Ekumen-OS/andino/(threads)

Thread 30 (2023-04-09):

[Simulation] Gazebo ROS control crashes the robot

stevendes, 2023-04-09:
### Summary

Using Gazebo ROS Control with the current robot configuration sometimes crashes the robot under specific movements, high values for the PID, or high-velocity commands being sent.

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

Different mass values improve the behavior, indicating that it could be an issue with the Inertia values and how Gazebo ROS control interacts.

### Definition of done
 - [ ] Gazebo ROS control works as expected.

francocipollone, 2024-03-20:
Closing as noetic isn't supported anymore

Closed 2024-03-20.

Thread 31 (2023-04-09):

[URDF] Wheel Axis are not aligned with base_link

stevendes, 2023-04-09:
### Summary

The current implementation of the Carpincho URDF has an offset between `base_link` and the `front_right_wheel` and `front_left_wheel`  axis, this influences localization since the robot movement also gets affected by that offset.

The fix would be to modify the position of `base_link` to be between the wheels, sharing the same axis.

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
_View of the base_link and the wheels_

### Definition of done
 - [ ] Carpincho URDF file updated with the correct values.

francocipollone, 2024-03-20:
Closing as it was part of the noetic branch which is not supported anymore

Closed 2024-03-20.

Thread 47 (2023-06-07):

Provide a gazebo simulation

francocipollone, 2023-06-07:
## Context
We already have a gazebo simulation at noetic branch but it was an old implementation. The urdf description way different than the current one.

## Summary
 - Create gazebo ROS2 simulation
 - Gracefully deal with urdf descriptions for:
   - real robot (ros2_control)
   - simulation using ros2_control
   - simulation using diff_drive plugin. (long shot, might not be necessary)

## Notes
 - an `andino_gazebo` package is expected to be created
 - I expect no gazebo references to andino_description's urdf description. Gazebo references should be part of the andino_gazebo package.

Voldivh, 2023-06-28:
## Task Description
Taking into account the initial issue description and that we have started working in doing a contribution for this issue, we have defined the following task in order to accomplish the

- [ ] The robot model for the Andino bot is included in the simulation environment within Gazebo Classic.
- [ ] The robot should be integrated with the following sensors:
- Wheel encoders
- Camera
- Lidar
- IMU (**if determined necessary, taking into account that the physical version of the Andino does not have an IMU**)
- [ ] Use ROS 2 Control to move the robot's wheels.
- [ ] Generate a launch file that is able to start the Gazebo simulation with the Andino bot in a environment.

### Notes
This feature should be implemented as a standalone package.

francocipollone, 2023-06-29:
Hey there I have some pointers on this topic.

## Implementation Suggestion

### URDF
- `andino_description` contains the description of the robot. I'd recommend not adding gazebo references within `andino_description` in order to make it simulator agnostic.
For so, I'd recommend having a xacro file within `andino_gazebo` package that include the main xacro from `andino_description` and add the gazebo references that this needs.

### ROS 2 control
Use https://github.com/ros-controls/gazebo_ros2_control . This package provides the "gazebo hardware interface" to be used between the diff drive controller and gazebo

### Sensors
IMU isn't part of the robot or the description yet. It's ok to add the IMU to the description, however, I'd suggest doing it in two steps. First, make sure the simulation is working with what you have as it is, and then, as a second step/enhacenment we can add the IMU to the description and the correspondent IMU controller(for gazebo).

agalbachicar, 2023-07-06:
@olmerg this ticket has been closed but I want to confirm:

- Have we decided to include the camera?
- Is ROS 2 Control finally working with the closed PR?

Closed 2023-07-05.

Thread 48 (2023-06-07):

Set up Nav2

francocipollone, 2023-06-07:
### Summary

Enable [nav2 navigation](https://github.com/ros-planning/navigation2) in Andino.

### Suggestions
 - [x] Provide an andino_navigation package.
 - [ ] Provide a basic launch file to bring up nav2: Check [nav2_bringup](https://github.com/ros-planning/navigation2/blob/main/nav2_bringup/launch/bringup_launch.py) launch file.
      - A configuration file is expected to be added to a config folder within the package for setting up different nav2's systems and to be loaded by the launch file.
      - Probably some topics in Andino/Nav2 should be remapped (or relayed)

### Extras

https://arxiv.org/abs/2307.15236

agalbachicar, 2023-06-28:
@nahueespinosa there is an effort that is about to start now that will take care of this. Have you started it already? If so, let's join forces!

nahueespinosa, 2023-06-28:
@francocipollone  In fact, I haven't started yet, but it should be very easy. I'll unassign myself then. Happy to help whoever is going to take care of this task.

Voldivh, 2023-06-29:
I believe the issue description provide the necessary tasks needed to complete the feature. I would just like to complete it with a couple of comments related to the scope of the effort that is starting:
- The implementation of the nav2 is related to be on top of the Andino simulation in Gazebo, taking into account the completion of #47.
- We are expecting to use the whole nav2 library in order to do localization, planning, navigation, etc. However, we would also like to assess the possibility of using Beluga in order to replace nav2_amcl. I think this should be assessed in terms of the amount of time that implementation would take. @nahueespinosa Could you provide us some insight about this topic?

agalbachicar, 2023-06-29:
To the best of my knowledge, @francocipollone did something already with it.

nahueespinosa, 2023-06-29:
> However, we would also like to assess the possibility of using Beluga in order to replace nav2_amcl.
> ...
> Could you provide us some insight about this topic?

We already did this, here is a branch with example launch files https://github.com/Ekumen-OS/beluga/pull/213.

To start setting up localization with `nav2_amcl`, I'd recommend using this file as reference: https://github.com/ros-planning/navigation2/blob/main/nav2_bringup/launch/localization_launch.py

`beluga_amcl` is a drop-in replacement, so once `nav2_amcl` is working, it is only a matter of installing Beluga from source and replacing the localization node name in a launch file.

@francocipollone got `slam_toolbox` working as well.

francocipollone, 2023-06-29:
I would start by setting up Nav2 as it is, once that is working we can parallel the work in order to choose `beluga` as the replacement for `nav2_amcl`. `Beluga`'s binaries are not yet released via ROS 2 build farm so it demands an extra step of building the library. For the simulation, we can simply add this step to the dockerfile. For the real robot it is necessary to bring the repo and build it.

> @francocipollone got slam_toolbox working as well.

I will push some stuff to launch `slam_toolbox` https://github.com/Ekumen-OS/andino/issues/49 shortly

PS: Thanks @nahueespinosa for the `beluga`'s info :rocket:

agalbachicar, 2023-07-06:
I know @olmerg did some progress on this yesterday.
CC @elector102 as you may also help here.

olmerg, 2023-07-06:
this is the initial branch [olmerg/nav2_gazebo](https://github.com/Ekumen-OS/andino/tree/olmerg/nav2_gazebo).

Which is expected in this package?

hidmic, 2024-02-06:
Is this complete @francocipollone ?

francocipollone, 2024-02-06:
Superseded by #190

Closed 2024-02-06.

Thread 55 (2023-06-18):

Add a mesh for the camera mount

francocipollone, 2023-06-18:
This PR #54 doesn't provide meshes for the visual of the camera.

Closed 2023-06-30.

Thread 80 (2023-06-30):

Fix urdf's distance between first and second story

francocipollone, 2023-06-30:
## Summary

Go over real robot sizes and adjust urdf description.

Closed 2023-06-30.

Thread 87 (2023-07-03):

Improve firmware code base

jballoffet, 2023-07-03:
## Desired behavior
Firmware code base shall be improved so as to ease its maintenance, decouple logic and drivers code (to ease the process of using a different dev board / microcontroller) and add unit tests.

elector102, 2023-07-06:
I can work on that! I have some experience and I made some investigation before for noah.

jballoffet, 2023-07-06:
Hi Fabri! I'm currently working on it, I will sync with you later on the lessons learned from the noahbot. Thanks for the heads up!

JesusSilvaUtrera, 2024-09-17:
@jballoffet we should close this issue since the PRs for improving the firmware were already merged.

jballoffet, 2024-09-17:
I concur, this can be closed now. Thanks!

Closed 2024-09-17.

Thread 92 (2023-07-04):

Adds tests for verifying andino_description urdf parsing.

francocipollone, 2023-07-04:
## Desired behavior
Adds some smoke tests in `andino_description` package for processing the xacro files and checking that there is no error when doing so.

JesusSilvaUtrera, 2024-05-10:
I will take this one. I suppose adding an unit test that loads the xacro file would be enough as a starting point.

Closed 2024-05-15.

Thread 93 (2023-07-06):

Wheel size does not match description/controller

BarceloChristian, 2023-07-06:
## Environment
* OS Version: <!-- e.g, Ubuntu 20.04 -->
* Source or binary build?
  <!-- If binary, which version? -->
  <!-- If source, which branch and what is the latest commit? -->

## Description
* Expected behavior:
  - Wheel size is defined the same across all the stack
* Actual behavior:
  - Wheel **Diameter** is defined to 0.035 for Gazebo's diff drive plugin ([here](https://github.com/Ekumen-OS/andino/blob/humble/andino_gazebo/urdf/andino.gazebo.xacro#L75))
  - Wheel **Radius** is defined to 0.0331 ([here](https://github.com/Ekumen-OS/andino/blob/humble/andino_description/config/andino/wheel.yaml#L2))

elector102, 2023-07-06:
@BarceloChristian @francocipollone what is the real value?

francocipollone, 2023-07-06:
> @BarceloChristian @francocipollone what is the real value?

The real value of the **Diameter** is 6.6 cm

agalbachicar, 2024-03-19:
@JesusSilvaUtrera will take care right away of this task as he gets to know the platform and this seems to be great issue to begin with.

JesusSilvaUtrera, 2024-03-20:
I have created this [https://github.com/Ekumen-OS/andino/pull/230](PR) for this issue

Closed 2024-03-20.

Thread 94 (2023-07-06):

Wrong xacro:if/unless definition for wheel's mesh

BarceloChristian, 2023-07-06:
## Description
* Expected behavior:
  - A single mesh is added to wheels, with different directives depending if scale is defined or not
* Actual behavior:
  - Meshes are added twice if scale is not defined

## Steps to reproduce
<!-- Provide steps so we can try to reproduce this issue -->

1. Transpile Andino's xacro, and check the wheels' mesh field.

Closed 2023-07-06.

Thread 96 (2023-07-06):

Caster wheel have a wrong behavior

elector102, 2023-07-06:
## Environment
* OS Version: 22.04
* Source

## Description
* Expected behavior: robot moving regarding command vels
* Actual behavior: caster wheel is stuck and don't move correctly

## Steps to reproduce

1. Run Andino simulation on empty world,
2. move the robot and rotate.

## Output
robot movement on gazebo is not regarding with the command vels. I will fix that commands

elector102, 2023-07-06:
I will fix that.

Closed 2023-07-06.

Thread 99 (2023-07-06):

Add option to generate Fixed or Continuous joint for caster wheel

BarceloChristian, 2023-07-06:
## Desired behavior
The caster wheel rotates freely when the robot moves

## Implementation suggestion
Add a flag to XACRO to generate the required joints.
Keep default as is

Closed 2023-07-06.

Thread 110 (2023-07-12):

simulation problem of andino with ros control

olmerg, 2023-07-12:
## Environment
* OS Version: Ubuntu 22.04 (dockerfile)
* Source from humble branch

## Description
* Expected behavior: After delete the hack in andino_gazebo/launch/spawn_robot_launch.py (function get_robot_description) the robot simulation with ros control works  without any issue
* Actual behavior:Gazebo simulation with ros control and caster wheel working complete  made that the robot do not move in straight-line.

## Steps to reproduce

1. Delete line in andino_gazebo/launch/spawn_robot_launch.py
   ```
    robot_desc = robot_desc.replace(
        '<joint name="caster_rotation_joint" type="continuous">',
        '<joint name="caster_rotation_joint" type="fixed">',
    )
   ```
2. Follow readme of andino_gazebo to build the packages
3. run simulation with ros control
`ros2 launch andino_gazebo andino_one_robot.launch.py use_gazebo_ros_control:=true`
5. move the robot from ros using
`ros2 run teleop_twist_keyboard teleop_twist_keyboard cmd_vel:=diff_controller/cmd_vel_unstamped`

## Output

After solve this problem is required to add to the joint_state_publisher plugin the joint to solve robot_state_publishers problems.

We have tested changing with different values the friction in   andino_gazebo/urdf/andino.gazebo.xacro without success. Some comments you can found in the pull #105

Closed 2023-10-09.

Thread 117 (2023-07-13):

The dependencies are not well fulfilled.

elector102, 2023-07-13:
## Environment
* OS Version: ubuntu 22, ros humble
* Source, humble branch

## Description
We are having some dependencies issues using humble branch on a CI. You can see the current dependencies on that image:
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

The problem is that andino Gazebo and andino description depend on andino control, and this dependency is fulfilled indirectly.
on the CI we run to compile and then run the test the following:
`colcon build --packages-up-to andino_gazebo aws_robomaker_small_warehouse_world andino_master --event-handlers console_cohesion+
`
and then:
`colcon test --packages-select andino_gazebo aws_robomaker_small_warehouse_world andino_master --event-handlers console_cohesion+`
where andino_master are gazebo tests.
With that the dependency of andino gazebo is not fulfilled and CI fail

francocipollone, 2023-07-13:
Thanks for filling up the issue @elector102 : Check https://github.com/Ekumen-OS/andino/pull/118

francocipollone, 2023-07-13:
> CI fail

What is the issue?

Now I am realizing that it is ok that `andino_control` is not a dependency to `andino_gazebo`. I think that the dependency that is missing is `controller_manager`

francocipollone, 2023-07-13:
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

Oh yeat it is being used when finding the controller's parameters

https://github.com/Ekumen-OS/andino/blob/5236b1132343539e19c2eb63c61e5f5f7814555b/andino_gazebo/urdf/andino.gazebo.xacro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

agalbachicar, 2023-07-13:
There is another occurency:

https://github.com/Ekumen-OS/andino/blob/humble/andino_description/urdf/andino.urdf.xacro#L84-L87

That imports files from `andino_control` and if `andino_description` includes `andino_control` as a dependency, then you have a circle one.

#118 deals with the issue, but the urdf files need to be ordered to solve this problem.

francocipollone, 2023-07-13:
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

```xml
<xacro:include filename="$(find ${package_name})/urdf/include/andino_control.urdf.xacro" />
```

Here `package_name` unpacks to `andino_description` so it isn't looking for stuff in `andino_control` package.
So I don't see the cycling dependency.

**It is true though** that if we are strict we could move the `andino_control.xacro.urdf` to `andino_control` package in order to extend the base description to ros control if needed.

However, based on taking a look at other robots descriptions, in general they add the ros control stuff within the base urdf description and it is quite accepted.

francocipollone, 2023-08-02:
Pinging @agalbachicar to define the bug if any. I will close this otherwise

Closed 2023-10-11.

Thread 121 (2023-07-14):

License notice missing on Docker bash scripts

jballoffet, 2023-07-14:
## Desired behavior
The license notice is currently missing on some Docker bash scripts.

Closed 2023-07-14.

Thread 134 (2023-08-05):

L298N wiring diagram not correct

Russ76, 2023-08-05:
Do you really have your robot driving around with wiring like in the diagram under hardware?

For it appears somewhat like the wiring for a stepper motor, but L298N can only control one stepper motor!

For powering two motors, with variable speeds, the wiring connections are different.

https://tronixstuff.com/2014/11/25/tutorial-l298n-dual-motor-controller-modules-and-arduino/

Also, the 5V terminal is for output, not for input. The Voltage regulator on the module can supply 5V to Arduino or encoders if properly wired.

Russ

## Environment
* OS Version: <!-- e.g, Ubuntu 20.04 -->
* Source or binary build?
  <!-- If binary, which version? -->
  <!-- If source, which branch and what is the latest commit? -->

## Description
* Expected behavior: <!-- Tell us what you expected to happen -->
* Actual behavior: <!-- What happened instead -->

## Steps to reproduce
<!-- Provide steps so we can try to reproduce this issue -->

1.
2.
3.

## Output
<!-- Provide screenshots, console logs, backtraces, and/or anything that could
be useful to us resolving this issue -->

francocipollone, 2023-08-06:
Thanks for commenting, let me go through your comment.

> For it appears somewhat like the wiring for a stepper motor, but L298N can only control one stepper motor!

L298N can control one stepper motor or two dc motors. The latter is our case, so we are ok.

> For powering two motors, with variable speeds, the wiring connections are different.

Base on what you say that the connection is different? Can you elaborate?

> Also, the 5V terminal is for output, not for input.

That's depend, you can remove the jumper (as indicated in the picture) and avoid using the internal 5v regulator to supply directly the current for the l298.

> The Voltage regulator on the module can supply 5V to Arduino or encoders if properly wired.

That's a decision yes, you can go that path. The diagram is a suggestion that works but the end design is open to the user.
For example, adding a step up to raise to 9V from 5V the voltage of the motor (at the l298 input) is a recommendation to have better reaction from the motors.

Russ76, 2023-08-06:
For powering two motors, the enable pins are necessary and are used for PWM for motors. The other two pair are for direction control and are only digital high or low. It looks to me like you have wiring connections correct for the BTS controller, which uses 2 PWM wires for each motor, one for forward, and one for reverse.

Closed 2023-12-07.

Thread 135 (2023-08-16):

Allow to load custom configuration for the description

francocipollone, 2023-08-16:
### Context

Nowadays the configuration files that describe the robot are located at:
https://github.com/Ekumen-OS/andino/tree/humble/andino_description/config/andino

However if the user wanted to have it a bit different; `motors` added in a different manner, `lidar` displaced and connected somwhere else, `base` with different size; they should create their own URDF files as the configuration files are harcoded within the [`xacro` file](https://github.com/Ekumen-OS/andino/blob/humble/andino_description/urdf/andino.urdf.xacro)

### Proposal
- Modify the xacro to receive by argument the path to the configuration files
- Use as default the current files if no argument is passed down to the xacro files.
- Modify the launch file to accept passing the path to the configuration yaml.

### Also!
 - Update documentation

JesusSilvaUtrera, 2024-03-26:
@francocipollone We should close this issue if it is already solved and merged

jballoffet, 2024-05-08:
@lneumarkt, are you currently working on this? No worries if not, just let us know since @JesusSilvaUtrera was considering picking it up. Thanks!

lneumarkt, 2024-05-08:
I'm not working on is. Feel free to pick it up

jballoffet, 2024-05-08:
Got it, thanks @lneumarkt for the prompt response!

JesusSilvaUtrera, 2024-05-09:
Thanks @lneumarkt for the response, I will take this issue.

Closed 2024-05-15.

Thread 148 (2023-09-04):

Velocity not limited for the diff drive controller

IDavGal, 2023-09-04:
## Description
The [`andino_controllers.yaml`](https://github.com/Ekumen-OS/andino/blob/humble/andino_control/config/andino_controllers.yaml) configuration file specify no limits in the linear/angular velocity. According the [motor's description](https://www.sparkfun.com/products/16413) its max velocity is 90 RPM, given the wheel radius this would translate to roughly 0.33 m/s linear vel.
The `diff_drive_controller` handles both [velocities limits separately](https://github.com/ros-controls/ros2_controllers/blob/1dac309979fb9392dc12feb6b46555582fed6fc6/diff_drive_controller/src/diff_drive_controller.cpp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), so the border case in which `linear_vel + angular_vel` translates to a higher motor velocity than 90 RPM is not considered by this calculation.

IDavGal, 2023-10-04:
There is an open PR in [`ros2_controllers`](https://github.com/ros-controls/ros2_controllers/pull/471) addressing this issue, although is currently pause.
I'll try to either bump it up or address the issues myself.

francocipollone, 2023-10-04:
> There is an open PR in [`ros2_controllers`](https://github.com/ros-controls/ros2_controllers/pull/471) addressing this issue, although is currently pause. I'll try to either bump it up or address the issues myself.

I should run a local test in the real robot and provide a real-based approximation, wdyt?
My estimation is that we are going to be below 0.5 m/s without effort.

Thread 159 (2023-09-28):

andino_base fails build in ros build farm

francocipollone, 2023-09-28:
### Summary

andino_base package is failing to build in the ros build farm due to

```
10:35:36 [ 42%] Building CXX object applications/CMakeFiles/motor_driver_demo.dir/motor_driver_demo.cpp.o
10:35:36 [ 57%] Linking CXX executable motor_driver_demo
10:35:36 /usr/bin/ld: CMakeFiles/motor_driver_demo.dir/motor_driver_demo.cpp.o: in function `andino_base::MotorDriver::MotorDriver()':
10:35:36 motor_driver_demo.cpp:(.text._ZN11andino_base11MotorDriverC2Ev[_ZN11andino_base11MotorDriverC5Ev]+0x18): undefined reference to `LibSerial::SerialPort::SerialPort()'
10:35:36 /usr/bin/ld: CMakeFiles/motor_driver_demo.dir/motor_driver_demo.cpp.o: in function `andino_base::MotorDriver::~MotorDriver()':
10:35:36 motor_driver_demo.cpp:(.text._ZN11andino_base11MotorDriverD2Ev[_ZN11andino_base11MotorDriverD5Ev]+0x18): undefined reference to `LibSerial::SerialPort::~SerialPort()'
10:35:36 /usr/bin/ld: ../src/libmotor_driver.so: undefined reference to `LibSerial::SerialPort::SetCharacterSize(LibSerial::CharacterSize const&)'
10:35:36 /usr/bin/ld: ../src/libmotor_driver.so: undefined reference to `LibSerial::SerialPort::Write(std::__cxx11::basic_string<char, std::char_traits<char>, std::allocator<char> > const&)'
10:35:36 /usr/bin/ld: ../src/libmotor_driver.so: undefined reference to `LibSerial::SerialPort::FlushIOBuffers()'
10:35:36 /usr/bin/ld: ../src/libmotor_driver.so: undefined reference to `LibSerial::SerialPort::SetBaudRate(LibSerial::BaudRate const&)'
10:35:36 /usr/bin/ld: ../src/libmotor_driver.so: undefined reference to `LibSerial::SerialPort::ReadLine(std::__cxx11::basic_string<char, std::char_traits<char>, std::allocator<char> >&, char, unsigned long)'
10:35:36 /usr/bin/ld: ../src/libmotor_driver.so: undefined reference to `LibSerial::SerialPort::Open(std::__cxx11::basic_string<char, std::char_traits<char>, std::allocator<char> > const&, std::_Ios_Openmode const&)'
10:35:36 /usr/bin/ld: ../src/libmotor_driver.so: undefined reference to `LibSerial::SerialPort::IsOpen() const'
10:35:36 /usr/bin/ld: ../src/libmotor_driver.so: undefined reference to `LibSerial::SerialPort::SetRTS(bool)'
10:35:36 /usr/bin/ld: ../src/libmotor_driver.so: undefined reference to `LibSerial::SerialPort::SetStopBits(LibSerial::StopBits const&)'
10:35:36 /usr/bin/ld: ../src/libmotor_driver.so: undefined reference to `LibSerial::SerialPort::SetFlowControl(LibSerial::FlowControl const&)'
10:35:36 /usr/bin/ld: ../src/libmotor_driver.so: undefined reference to `LibSerial::SerialPort::SetDTR(bool)'
10:35:36 /usr/bin/ld: ../src/libmotor_driver.so: undefined reference to `LibSerial::SerialPort::SetParity(LibSerial::Parity const&)'
10:35:36 collect2: error: ld returned 1 exit status
10:35:36 gmake[2]: *** [applications/CMakeFiles/motor_driver_demo.dir/build.make:98: applications/motor_driver_demo] Error 1
10:35:36 gmake[1]: *** [CMakeFiles/Makefile2:172: applications/CMakeFiles/motor_driver_demo.dir/all] Error 2
10:35:36 gmake: *** [Makefile:146: all] Error 2
```

See https://build.ros2.org/job/Hdev__andino__ubuntu_jammy_amd64/3/console

francocipollone, 2023-10-03:
From jenkins output:
```
Could NOT find PkgConfig (missing: PKG_CONFIG_EXECUTABLE)
```

https://build.ros2.org/job/Hdev__andino__ubuntu_jammy_amd64/3/console

Closed 2023-10-04.

Thread 160 (2023-10-02):

Improve lidar mesh

francocipollone, 2023-10-02:
## Description
* Current lidar mesh is unnecessarily too complex (more than 26k triangles), which might cause an issue when using this mesh in simulations and for correctly casting shadows

Closed 2023-10-09.

Thread 169 (2023-10-30):

Adds camera_info yaml file

francocipollone, 2023-10-30:
### Summary

When launching the camera we are not passing a yaml with the description of the camera's intrinsics

https://github.com/Ekumen-OS/andino/blob/024b6943e5813c2b555b3f74e0e4e97f8ed21cba/andino_bringup/launch/camera.launch.py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

### Notes

- https://navigation.ros.org/tutorials/docs/camera_calibration.html#overview
- https://gitlab.com/boldhearts/ros2_v4l2_camera
- https://github.com/tier4/ros2_v4l2_camera/blob/87d0ff0d24302124ee9a4b8e00ad6d675446b2e3/launch/v4l2_camera.launch.py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

### Definition of done

 - [ ] Adds a default yaml file descringin camera intrinsic.
 - [ ] Adds documentation about how to calibrate the camera if needed.

JesusSilvaUtrera, 2024-03-20:
I will take care of this issue

JesusSilvaUtrera, 2024-03-20:
I have created this [PR](https://github.com/Ekumen-OS/andino/pull/231) @agalbachicar

Closed 2024-06-17.

Thread 170 (2023-10-30):

Enable compressed image transport

francocipollone, 2023-10-30:
### Summary

Nowadays the images from the camera are only raw images

### Notes

 - Simply installing the correspondent image transport plugijn will enable the compressed image to be also published
 - In order to visualize images in RViz2 you will need to uncompress the image as it natively doesn't support compressed images to be viewed.
   - `ros2 run image_transport republish compressed in/compressed:=image_raw/compressed raw out:=image_raw/uncompressed`
### Definition of done

- [ ] Provide compressed image transport
- [ ] Adds documentation about compressed image visualization

JesusSilvaUtrera, 2024-03-20:
I will take care of this issue

JesusSilvaUtrera, 2024-03-20:
I have reviewed this, and the package 'ros-humble-image-transport-plugins' is installed automatically when the 'rosdep' command is used, as well as its dependencies (```sudo apt install libtheora-dev libogg-dev libboost-python-dev```), so there are no changes needed there.

On the other side, as 'ros-humble-image-transport' is also installed when running 'rosdep', we can use the 'republish' node to uncompress the image and see it in RViz:

```sh
ros2 run image_transport republish raw --ros-args --remap in:=/image_raw/compressed --remap out:=/image_raw/uncompressed
```

The syntax used for this node is different than the one @francocipollone used, because it says that syntax is deprecated.

For evidence, you can see the output of the node 'list_transports':

```sh
jesus-silva@themis:~/ws$ ros2 run image_transport list_transports
Declared transports:
image_transport/compressed
image_transport/compressedDepth
image_transport/raw
image_transport/theora

Details:
----------
"image_transport/compressed"
 - Provided by package: compressed_image_transport
 - Publisher:
      This plugin publishes a CompressedImage using either JPEG or PNG compression.

 - Subscriber:
      This plugin decompresses a CompressedImage topic.

----------
"image_transport/compressedDepth"
 - Provided by package: compressed_depth_image_transport
 - Publisher:
      This plugin publishes a compressed depth images using PNG compression.

 - Subscriber:
      This plugin decodes a compressed depth images.

----------
"image_transport/raw"
 - Provided by package: image_transport
 - Publisher:
      This is the default publisher. It publishes the Image as-is on the base topic.

 - Subscriber:
      This is the default pass-through subscriber for topics of type sensor_msgs/Image.

----------
"image_transport/theora"
 - Provided by package: theora_image_transport
 - Publisher:
      This plugin publishes a video packet stream encoded using Theora.

 - Subscriber:
      This plugin decodes a video packet stream encoded using Theora.
```

I will try to test this with my webcam as I don't have the Andino at home to check all works without problems.

JesusSilvaUtrera, 2024-03-20:
I have been struggling for a while to open my webcam using image_transport:

```sh
[ WARN:0] global ./modules/videoio/src/cap_gstreamer.cpp (616) isPipelinePlaying OpenCV | GStreamer warning: GStreamer: pipeline have not been created
[ WARN:0] global ./modules/videoio/src/cap_v4l.cpp (890) open VIDEOIO(V4L2:/dev/video0): can't open camera by index
[ros2run]: Process exited with failure 1
```

When I perform a ```ls /dev/video*´´´ the webcam is found, but I think docker is not able to access it inside the container, since the container is not being run with 'privileged' access. I have tried with an app like 'cheese' and indeed, the webcam is not being accessed even though it is detected, so I can't continue with this.

JesusSilvaUtrera, 2024-03-20:
@agalbachicar to keep you updated.

francocipollone, 2024-03-20:
> When I perform a ```ls /dev/video*´´´ the webcam is found, but I think docker is not able to access it inside the container, since the container is not being run with 'privileged' access. I have tried with an app like 'cheese' and indeed, the webcam is not being accessed even though it is detected, so I can't continue with this.

Are you using the docker provided in this repo? It is actually running with `--privileged` flag

https://github.com/Ekumen-OS/andino/blob/humble/docker/run.sh#L107-L116

Probably you could try also adding a bind volume `-v` to /dev. You can modify the run.sh script locally for trying that

JesusSilvaUtrera, 2024-03-20:
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

Yeah I am using the docker provided, so if it uses the ```--privileged``` flag by default it is a strange behavior. I will try what you suggests later, thanks Franco!

JesusSilvaUtrera, 2024-03-21:
@francocipollone trying with the new volume worked, now I can see my webcam inside the docker container and I can publish the images as ROS msg.

The results are that indeed if the plugins are installed (and they are installed by default after `rosdep`) these topics are published:

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

So as you can see both the compressed and the raw image are published, so there is no need to 'republish' the compressed image as raw to see it in RViz, you can simply use the raw image in RViz.

The problem with this is the bandwidth, because it would be more convenient if we could simply publish only the formats we want (in this case the raw and compressed, the others are not important).

I will look into that and be back here

JesusSilvaUtrera, 2024-03-21:
I have tried it, and although the topic is being republished with `sensor_msgs/msg/Image` type, it is not possible to see it on RViz:

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

On the other hand, I have looked if it is possible to publish only some of transports, and the only information I have found is [this](https://github.com/ros-perception/image_transport_tutorials?tab=readme-ov-file#adding-new-transports) so far.

JesusSilvaUtrera, 2024-03-22:
@agalbachicar in case you want to check the updates :)

JesusSilvaUtrera, 2024-05-24:
@francocipollone I think we can close this issue given the results:

- The compressed image is being published automatically when you have the plugins installed, and the node also publishes the original image uncompressed.
- Rviz2 still doesn't support compressed images visualization, but we can use the original uncompressed `/camera/image` topic.

Let me know what you think and if you want to test anything else now that I have the Raspy Cam.

francocipollone, 2024-06-09:
Sorry for the late reply.
Thanks for the investigation @JesusSilvaUtrera, it is much appreciated!
We can close this

Closed 2024-06-09.

Thread 174 (2023-11-19):

Terminate called after throwing an instance of 'std::runtime_error'

mlde50, 2023-11-19:
## Environment
* OS Version:
```
lsb_release -a
No LSB modules are available.
Distributor ID:	Ubuntu
Description:	Ubuntu 22.04.3 LTS
Release:	22.04
Codename:	jammy
```
* ROS2 Humble updated
* Andino - Commits on Oct 9, 2023

## Description
* Check motor with motor_driver_demo
```
 motor_driver_demo --msg='o 255 255'
```
* Actual behavior:
```$ motor_driver_demo --msg='o 255 255'
Motor driver is connected: True
Waiting 2 seconds for the Microcontroller to be ready...
Sending message: o 255 255
Response to o 255 255 timed out.
Response:
terminate called after throwing an instance of 'std::runtime_error'
  what():  Input/output error
Aborted (core dumped)
```
## Steps to reproduce
1.
```
$ motor_driver_demo --serial_port=/dev/ttyUSB0 --msg='e'
```
2.
```
$ motor_driver_demo --msg='o 255 255'
```

## Output
1.
```
Motor driver is connected: True
Waiting 2 seconds for the Microcontroller to be ready...
Sending message: e
Response: 0 0
```
2.
```
Motor driver is connected: True
Waiting 2 seconds for the Microcontroller to be ready...
Sending message: o 255 255
Response to o 255 255 timed out.
Response:
terminate called after throwing an instance of 'std::runtime_error'
  what():  Input/output error
Aborted (core dumped)
```

francocipollone, 2023-11-21:
Hey @mlde50 thanks for filling this in, I will try to replicate this locally whenever I have a chance.
In the meantime, just in case, have you checked the configuration part at https://github.com/Ekumen-OS/andino/tree/humble/andino_hardware#arduino ?

francocipollone, 2023-11-21:
@mlde50  Note that the `motor_driver_demo` app is just sending messages to the Arduino. You can try sending those very same commands via Arduino IDE so we can narrow down the issue and check if your connection with the Arduino is working properly.

After loading the firmware into the Arduino uno/nano platform you can open the Serial Monitor, indicate the Baud Rate(57600) and  CR (carriage return)

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

 and send:
- `e` --> for getting the encoders values
- `o 255 255`

This is a bit explained at https://github.com/Ekumen-OS/andino/tree/humble/andino_firmware#andino_firmware

mlde50, 2023-11-22:
Hey @francocipollone, thanks for your reply. I did more investigation with latest commit and Arduino monitor application tool. And I have some strange behavior. When power on arduino Nano, "e" command return encoder value
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

But when I send "o 255 255" command motor doesn't rotate and communication between computer and Arduino is lost, impossible to resend now command without unplug and plugin arduino.

mlde50, 2023-11-25:
Hey @francocipollone, I reinstall every things and it's seems ok  now.

Closed 2023-11-25.

Thread 184 (2023-11-29):

Arduino Firmware - Command "o" not working

german-e-mas, 2023-11-29:
## Description
After compiling and uploading the [andino_firmware](https://github.com/Ekumen-OS/andino/tree/humble/andino_firmware) into the Arduino, the `o` command did not work.

Commands such as `m 255 255` were correctly interpreted. The speed was also properly controlled (`128` was half as fast, for example). But the `o` command did nothing. It did not move the motors.

## Environment
- https://github.com/Ekumen-OS/andino/tree/humble/andino_firmware

jballoffet, 2023-11-29:
Thanks @german-e-mas for reporting this issue!

I confirm that I am able to reproduce the issue locally. I will dive into this as part of the work that I'm currently doing related to refactoring the code related to the commands and the application main loop (https://github.com/Ekumen-OS/andino/blob/humble/andino_firmware/src/app.cpp).

Thank you!

Closed 2024-02-12.

Thread 188 (2023-12-04):

CI failing due to upstream error

francocipollone, 2023-12-04:
### Context

CI is failing due to a certain collision between empy and em packages.

```
  [1.140s] ERROR:colcon.colcon_core.entry_point:Exception loading extension 'colcon_core.shell.powershell': cannot import name 'OVERRIDE_OPT' from 'em' (/usr/local/bin/em.py) The Python package 'empy' must be installed and 'em' must not be installed since both packages share the same namespace
  Traceback (most recent call last):
    File "/usr/local/lib/python3.10/dist-packages/colcon_core/entry_point.py", line 120, in load_entry_points
      extension_type = load_entry_point(entry_point)
    File "/usr/local/lib/python3.10/dist-packages/colcon_core/entry_point.py", line 166, in load_entry_point
      return entry_point.load()
    File "/usr/local/lib/python3.10/dist-packages/pkg_resources/__init__.py", line 2465, in load
      return self.resolve()
    File "/usr/local/lib/python3.10/dist-packages/pkg_resources/__init__.py", line 2471, in resolve
      module = __import__(self.module_name, fromlist=['__name__'], level=0)
    File "/usr/local/lib/python3.10/dist-packages/colcon_powershell/shell/powershell.py", line 17, in <module>
      from colcon_core.shell.template import expand_template
    File "/usr/local/lib/python3.10/dist-packages/colcon_core/shell/template/__init__.py", line 19, in <module>
      raise e from None
    File "/usr/local/lib/python3.10/dist-packages/colcon_core/shell/template/__init__.py", line 10, in <module>
      from em import OVERRIDE_OPT
  ImportError: cannot import name 'OVERRIDE_OPT' from 'em' (/usr/local/bin/em.py) The Python package 'empy' must be installed and 'em' must not be installed since both packages share the same namespace

```

It doesn't seem it is coming from our end

### Next steps
 - Investigate why this is failing

Closed 2023-12-04.

Thread 190 (2023-12-15):

Improve andino_navigation package

francocipollone, 2023-12-15:
### Summary

Improve `andino_navigation` package to make it easier to the user to use nav2 on the real robot as well as to decouple `andino_navigation` from the simulation.

### Tasks:
 - [x] Test `andino_navigation/launch/bringup.launch.py` launch file with real robot.
       - Tune parameters for a better experience.
       - Note odom topic is different in simulation and in real robot. (Should we here try to standarize it?)
         - Temporarily having two param files might be ok.
 - [ ] ~Include nav bringup at a `andino_bringup` package level so it is easier to launch everything.~
 - [ ] Move `andino_navigation/launch/andino_simulation_navigation.launch.py` file to `andino_gz_classic` package as it depends on gazebo.

agalbachicar, 2024-02-06:
If I may:

>  Include nav bringup at a andino_bringup package level so it is easier to launch everything.

Keep it separate and be more atomic with your package dependencies. If you just want to have basic sensor / actuator functionality, the nav stack would make it bring a plethora of dependencies you don't want.

> Move andino_navigation/launch/andino_simulation_navigation.launch.py file to andino_gz_classic package as it depends on gazebo.

Actually, one of the things I struggled the most with is the coupling in the packages. I would highly recommend to have launchfiles that are specific to the nav stack than only care about loading the nodes that are required for that and then demos / integration packages that would put pieces together. That would help also to make sure you can select, as a user, where to launch things (physical machine / docker container).

francocipollone, 2024-02-13:
> Keep it separate and be more atomic with your package dependencies. If you just want to have basic sensor / actuator functionality, the nav stack would make it bring a plethora of dependencies you don't want.

Thanks for the suggestion. Agree with you about the dependencies nav2 would bring at `andino_bringup` package

Closed 2024-02-14.

Thread 192 (2023-12-21):

Migrate to modern Gazebo

azeey, 2023-12-21:
## Desired behavior
As you may know, Gazebo-classic (aka Gazebo11, see [Terminology](https://gazebosim.org/about#:~:text=Terminology)) is no longer being actively developed  and will not be available on ROS Jazzy ([REP 2000](https://www.ros.org/reps/rep-2000.html#jazzy-jalisco-may-2024-may-2029)). I noticed that this project still uses Gazebo-classic. Are there any plans to migrate to modern Gazebo ([previously known as Ignition](https://community.gazebosim.org/t/a-new-era-for-gazebo/1356))?

## Alternatives considered
n/a

## Implementation suggestion
Steps for Migration:

- Follow https://gazebosim.org/api/sim/8/migrationsdf.html to update SDF files
- Follow https://gazebosim.org/api/sim/8/migrationplugins.html to update custom plugins
- Update launch files to use [ros_gz](https://github.com/gazebosim/ros_gz/) instead of gazebo_ros_pkgs. Documentation for ros_gz can be found at https://gazebosim.org/docs/harmonic/ros2_integration. Another good resource is the [ros_gz_project_template](https://gazebosim.org/docs/harmonic/ros_gz_project_template_guide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).

## Additional context
n/a

francocipollone, 2023-12-21:
Hey @azeey thanks for the issue and suggestion in the implementation :smile: , it is useful indeed.
Happy to mention that it is already part of our backlog and it is under migration. We haven't opened it yet but we will do so shortly. (It isn't completely migrated I think we are still missing the sensors)

This won't replace the current gz_classic simulation but will provide an alternative, similar to what we did with [andino_webots](https://github.com/Ekumen-OS/andino_webots)

azeey, 2023-12-21:
That's great to hear!vLet me know if you run into any issues.

francocipollone, 2023-12-21:
> That's great to hear!vLet me know if you run into any issues.

Thanks!, I'll keep you posted! :rocket:

francocipollone, 2024-02-02:
- :heavy_check_mark:  Tackled at https://github.com/Ekumen-OS/andino_gz
- :heavy_check_mark:  Referenced at the readme: https://github.com/Ekumen-OS/andino?tab=readme-ov-file#paperclips-related-projects

Closed 2024-02-02.

Thread 198 (2023-12-28):

Camera from RPI has a driver issue in Ubuntu Mate 22.04 which prevents proper loading

agalbachicar, 2023-12-28:
## Environment
* OS Version: RPI 4, Ubuntu Mate 22.04.3, humble
* Source or binary build: source build, [2e552b5](https://github.com/Ekumen-OS/andino/commit/2e552b51e3333d6e2c6186defe8b8a15ad370f9d)

## Description
* Expected behavior: after running the installation guide in the RPI, and launching the base launchfile the camera would be up and working.
* Actual behavior: it does not work, fails with:
```
[v4l2_camera node-3] [ERROR] [1703759493.768683193] [v4l2_camera]: Failed stream start: Invalid argument (22)
```

## Steps to reproduce

1. Run the installation instructions in https://github.com/Ekumen-OS/andino/blob/humble/andino_hardware/README.md
2. Go to https://github.com/Ekumen-OS/andino/blob/humble/README.md#rocket-usage and try:
```
ros2 launch andino_bringup andino_robot.launch.py
```
The launch execution would fail with that error listed above.

## Notes

I checked and it seems this is a known error:

- https://robotics.stackexchange.com/questions/23967/raspberry-pi-ros-2-humble-on-ubuntu-22-04-server-v4l2-camera-reports-failed
- https://gitlab.com/boldhearts/ros2_v4l2_camera/-/issues/45

It seems there is a workaround with raspian distros, however I did not find the `/boot/firmware/config.txt` or any similar file under the `/boot` directory nor that configuration in any other file (`camera_auto_detect`).

## Hardware

- Rasberry PI camera module 2
- Raspberry PI 4 B 8GB

flsmr, 2024-05-19:
For me, the following fix got my raspi cam v2 work again (Ubuntu Mate 22.04 on Raspberry Pi 4B):
change/add the following lines within /boot/firmware/config.txt:

```
# Autoload overlays for any recognized cameras or displays that are attached
# to the CSI/DSI ports. Please note this is for libcamera support, *not* for
# the legacy camera stack
start_x=1
gpu_mem=128
# camera_auto_detect=1
```

francocipollone, 2024-05-19:
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

Thanks for sharing the fix @flsmr

JesusSilvaUtrera, 2024-05-27:
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

Exactly, I have tried my raspi cam v2 today and this was the solution to make it work, apart from enabling it in the raspberry configuration:

```
sudo raspi-config
```

Go to `Interface Options`, select `camera` and enable it. Then you just need to reboot and the camera should be working fine.

francocipollone, 2024-05-27:
We should update this fix to the instructions in case others face this very same issue.

JesusSilvaUtrera, 2024-05-27:
> We should update this fix to the instructions in case others face this very same issue.

I'm on it, it will be included in the #231 PR

Thread 200 (2023-12-28):

Provide a dockerized environment for ARM64

agalbachicar, 2023-12-28:
## Desired behavior

Reduce the time to deploy an Andino bot in a fully functional system.

## Alternatives considered

Probably there are many out there, like from a bash script, having an image of the SD card, etc. etc. etc.
However, I think that starting by having a dockerized version that can be built in a host machine (x86) that mimics the build procedure in the final architecture (arm64) allows to catch issues with incompatible processes and test many things in CI (not yet, Github Actions doesn't support arm64 yet).

## Implementation suggestion

I would consider building in stages and providing multiple images:

- Image for development in RPI, but with no workspace specific dependency. (A)
- Image that clones the repo, installs the workspace, builds and tests the packages in andino. (B)
- Image that mounts the repo as a volume and it is suitable for continuous development. (C)

B depends on A.
C depends on A.

A and B can be distributed via Github, probably.

## Additional context

Running https://github.com/Ekumen-OS/andino/tree/humble/andino_hardware is tedious. At least, we can reduce the burden by providing the specifics of software packages installed in a docker container.

agalbachicar, 2023-12-28:
Connected with https://github.com/Ekumen-OS/andino/discussions/20

agalbachicar, 2024-01-02:
Connected to #51

marcoshuck, 2024-01-03:
https://docs.docker.com/build/ci/github-actions/multi-platform/ In case this becomes relevant. You can set up QEMU to build arm64.

Thread 201 (2023-12-29):

Fix rosdep dependencies when installing in Raspeberry Pi

agalbachicar, 2023-12-29:
## Environment
* OS Version: Ubuntu 22.04 / Ubuntu Mate 22.04 - arm64/v8
* Source build: [9f7793d](https://github.com/Ekumen-OS/andino/commit/9f7793db6810d6d4deeca745ef18aeb86660a444)

## Description
* Expected behavior: running rosdep as listed in the guide does not lead to any error.
* Actual behavior: because the repository has the simulation packages, it fails to resolve all gazebo related dependencies and also one related to the turtlebot3 (potentially unused).

## Steps to reproduce

1. Run rosdep as described above and in the readmes when running in the RPI.

```
rosdep install --from-paths src --ignore-src -i -y
```

## Output

```
rosdep install --from-paths src --ignore-src -i -y
[...]
ERROR: the following rosdeps failed to install                                    
   apt: command [sudo -H apt-get install -y ros-humble-turtlebot3-gazebo] failed   
   apt: command [sudo -H apt-get install -y ros-humble-gazebo-ros-pkgs] failed     
   apt: command [sudo -H apt-get install -y ros-humble-gazebo-ros] failed          
   apt: command [sudo -H apt-get install -y ros-humble-gazebo-ros2-control] failed 
   apt: Failed to detect successful installation of [ros-humble-turtlebot3-gazebo] 
   apt: Failed to detect successful installation of [ros-humble-gazebo-ros-pkgs]   
   apt: Failed to detect successful installation of [ros-humble-gazebo-ros]        
   apt: Failed to detect successful installation of [ros-humble-gazebo-ros2-control]
```

agalbachicar, 2023-12-29:
I suspect we need to move the simulation specific packages to another repository to solve this issue.

robofoundry, 2024-01-27:
I ran into same issue and as instructions suggest you can continue installing remaining packages by using rosdep with -r switch OR you can also add COLCON_IGNORE empty file in package root folder you want to ignore. In this case it would be gz_classic, nav and slam packages. Or you can simply delete those three package directories on robot/RPi. HTH.

JesusSilvaUtrera, 2024-09-17:
@jballoffet I suppose we can also close this one, as using the `-r` flag with `rosdep` command solves the problem and also on Jazzy we have deprecated the simulation packages.

Thread 236 (2024-04-25):

Add support for the Bitcraze™ Lighthouse Positioning System

hidmic, 2024-04-25:
## Desired behavior
<!-- Describe the current problem and the feature you want implemented.-->
The [Lighthouse Positioning System](https://www.bitcraze.io/documentation/system/positioning/ligthouse-positioning-system/) by Bitcraze is a low-cost pose estimation system for their flagship product, the Crazyflie MAV. It uses a number of IR beacons and a receiver on a deck (the equivalent of Arduino shields) to provide the Crazyflie MAV with pose estimates in real-time.

If we could leverage this deck, we could provide Andino with pose tracking support. This is immensely useful when validating, tuning, and benchmarking localization, mapping, and navigation systems. Also when teaching about them.

## Alternatives considered
<!-- Describe alternate solutions or features you've considered.-->
There are other, full blown motion capture solutions in the market but these are exceedingly expensive when compared with Andino's target budget. We are talking tens of thousands of US dollars.

## Implementation suggestion
<!-- Provide a suggestion on how to implement this feature, which could help us
expedite this implementation.-->

The one difficulty with this is that both the hardware interface and the communication protocol are very loosely documented. The pinout for the [Lighthouse Positioning deck](https://www.bitcraze.io/documentation/hardware/lighthouse_deck/lighthouse_deck-datasheet.pdf) and for [Crazyflie expansion decks](https://www.bitcraze.io/documentation/system/platform/cf2-expansiondecks/) in general is public. The firmware that talks to this deck is also open source (see [here](https://github.com/bitcraze/crazyflie-firmware/tree/d9ee34a78cecf2eaf8b05e0b54487cff0c7b4590/src/modules/src/lighthouse) and [here](https://github.com/bitcraze/crazyflie-firmware/tree/d9ee34a78cecf2eaf8b05e0b54487cff0c7b4590/src/utils/src/lighthouse)). But the protocol itself is nowhere to be found. It can only be reversed engineered. It shouldn't be difficult to do so for one of the typical on-board computers for Andino (e.g. an RPi4).

hidmic, 2024-04-25:
> But the protocol itself is nowhere to be found. It can only be reversed engineered.

Aha! This may not be 100% true. We shall take a look at some of the documentation and tools over at https://github.com/bitcraze/lighthouse-fpga. Thanks @glpuga.

JCarosella, 2024-04-27:
Some info here, found the [Bitcrazy API for deck drivers](https://www.bitcraze.io/documentation/repository/crazyflie-firmware/master/userguides/deck/). This will help understand the src code linked above for the lighthouse driver code

JCarosella, 2024-05-02:
## Status update:

I was able to hook up the board to a RPi4 and start receiving data from the sensors with which the positioning algorithm could be implemented.

The bad news: I mistakenly connected the VCC/GND pins backwards and most likely burnt something. Most likely because the board turns on and responds to commands, but does not output sensor info (I think [the TS4231 IR receivers](https://www.bitcraze.io/documentation/hardware/lighthouse_deck/lighthouse_deck-revd.pdf) burnt).

I will be getting a replacement, but that puts the project on hold for a while (no US market, only Europe). I'll keep this issue updated.

Thread 239 (2024-04-30):

Update connections diagram

JesusSilvaUtrera, 2024-04-30:
## Desired behavior
The connections diagram doesn't include all the required parts and it is out-of-date, so it would be nice to update it with the latest changes to ease the assembly process.

## Implementation suggestion
Several considerations:
- The encoders and the motors are the same piece, so they should be together.
- The Raspberry is not included in the diagram
- Add the power part well explained, replacing the potato.
- The Arduino UNO should be replaced by an Arduino Nano (optional but the most used is the Nano for this robot)
- Add the LiDAR (optional as its wiring is not something too hard)

## Additional context

JesusSilvaUtrera, 2024-05-08:
To keep the issue updated, I am creating 3 diagrams in Google Drawings, one with the Arduino connections, the second with Raspberry Pi connections and the third for Power connections. I think this way is easier to follow the diagrams and then just connects the different diagrams into the final robot.

They won't be finished until I test them assembling my own robot.

francocipollone, 2024-05-08:
> To keep the issue updated, I am creating 3 diagrams in Google Drawings, one with the Arduino connections, the second with Raspberry Pi connections and the third for Power connections. I think this way is easier to follow the diagrams and then just connects the different diagrams into the final robot.
>
> They won't be finished until I test them assembling my own robot.

Sounds good!

Closed 2024-05-28.

Thread 240 (2024-04-30):

Update bill of materials

JesusSilvaUtrera, 2024-04-30:
## Desired behavior
There are some considerations to be taken into account with the bill of materials:
- The variants column should be removed IMO, because this robot is meant for people learning, and this would only create confusion in which parts to use.
- If the variants column is finally removed, the comments column should be removed too.
- The parts should be numerated in the table. This way we can edit the photos of the assembly process to show how every part look, at least in the first photo where all parts are shown (think about a person that is totally new to this and have never seen a Motor Driver in his life).
- Right now the links used are from the US if I am right, it would be nice to add links for EMEA also.

## Implementation suggestion
Update the README.md in `andino_hardware` with all these changes.

## Additional context
We can discuss other changes that you think it would be nice to add, or discard some of the ones I have proposed.

Closed 2024-04-30.

Thread 247 (2024-05-13):

USB ports not being well fixed on Raspberry Pi

JesusSilvaUtrera, 2024-05-13:
## Environment
* OS Version: Ubuntu 22.04 Mate
* Source or binary build?
  Using source code with branch `humble` and last commit `efb75b0`.

## Description
* Expected behavior: I am setting up everything in the Raspberry Pi 4B to use the LiDAR and the Arduino.  Following the instruction on the section `USB Port name configuration` in the `README.md` of `andino_hardware` package should lead to the result of the ports being well fixed..

* Actual behavior: When I follow the instructions to set the ports, I can see both the LiDAR and Arduino connected to USB ports. However, when I set the rules, only the first 2 lines of the expected output are visible, so the rules are not being well applied.

```sh
crw-rw---- 1 root dialout 188, 0 Sep  2 15:09 /dev/ttyUSB0
crw-rw---- 1 root dialout 188, 1 Sep  2 15:09 /dev/ttyUSB1
lrwxrwxrwx 1 root root         7 Sep  2 15:09 /dev/ttyUSB_ARDUINO -> ttyUSB0
lrwxrwxrwx 1 root root         7 Sep  2 15:09 /dev/ttyUSB_LIDAR -> ttyUSB1
```

## Steps to reproduce

1. Install `Ubuntu 22.04 Mate` on the Raspberry Pi
2. Execute `sudo apt update && sudo apt upgrade` to upgrade the OS packages
3. Follow the `README.md` of `andino_hardware`, section `USB Port name configuration`

## Output
<!-- Provide screenshots, console logs, backtraces, and/or anything that could
be useful to us resolving this issue -->

JesusSilvaUtrera, 2024-05-13:
My bad, the problem was a typo when I copied one of the ids and I didn't notice earlier. I also discovered that there is a preset rule for the RPLiDAR, if you execute `ls -l /dev | grep ttyUSB`, you will see that there is a `rplidar -> ttyUSB1` also.

Sorry for the inconveniences, I will now close the issue.

Closed 2024-05-13.

Thread 250 (2024-05-24):

[Hardware] - Update Raspberry Cam parts

JesusSilvaUtrera, 2024-05-24:
## Desired behavior
I have recently printed the 3D parts for the Raspberry Camera and noticed that the hinge model doesn't include the holes to screw it to the chassis (it would be nice if they can be M2 or M3). Also, the front and the back parts doesn't fit exactly, so I will need to add some silicon to them.

## Implementation suggestion
Modify the models in `andino_hardware/printing_model/raspi_cam_mount` to satisfy these new requirements.

## Additional context
The holes should coincide with the 2 holes at the front of the chassis.

Closed 2025-01-28.

Thread 272 (2024-10-27):

FAIL TO 'colcon build' THE FIRST TIME

thanhtruongphan, 2024-10-27:
Hello everyone! 👋

I just tried to download andino_repositories, and follow the README.md instructions to install.

But I have some problems when I use _**colcon build**_

1. When I ```colcon build``` the first time:
>>>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

I solved by ```sudo apt install ros-humble-ros2-control```

2. When I ```colcon build``` the second time:
>>> 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

I solved by ```sudo apt install ros-humble-ament-cmake-clang-format```

3. When I ```colcon build``` the third time:
>>>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

I solved by ```sudo apt install libserial-dev```

4. When I ```colcon build``` the fourth time:
>>>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

I solved by ```sudo apt-get install libgflags-dev```

5. When I ```colcon build``` the fifth time:
>>>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

... and now I don't know how to solve it.

Help me, pls.

Thank you all so much, and have a nice day! 🥹

thanhtruongphan, 2024-10-27:
UPDATE:

I tried to mode the line 12 and It's OK now.
>>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

result:
>>>>>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

thanhtruongphan, 2024-10-27:
and in SBC:
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

francocipollone, 2024-10-27:
Hey @thanhtruongphan , thanks for the issue creation.

1. I feel like the issues with the stuff not installed is due to some missing rosdep install: e.g: typically `rosdep install --from-paths src -y -i`

2. Regarding the issues and the modifications to the CMakeLists file you are doing. It is odd and not happening on my end last time a built everything (I am going to try asap when I return from a trip). Could you share your setup? e.g: OS / hardware/ etc

thanhtruongphan, 2024-10-28:
yeah!
you're right!

after ```sudo rosdep init``` and ```rosdep update```, I forget to ```rosdep install --from-paths src -y -i``` 😄

probably because of the errors in the previous project that made me stupid.

anyway, thank you so much for your reply.

have a nice day 🥹

Closed 2024-10-31.

Thread 274 (2024-10-28):

HOW TO RUN ON REAL ROBOT

thanhtruongphan, 2024-10-28:
I've set up all firmware both on SBC and dev-PC, 👋

I could run gazebo with teleop-twist-keyboard successfully,

but the Real-robot doesn't work...
I don't know how to do...

Can anyone help me, pls...

Thank you so much and have a nice day!! 🥹

>>> ![Screenshot 2024-10-28 214557](https://github.cI've set up all firmware both on SBC and dev-PC, 👋

I could run gazebo with teleop-twist-keyboard successfully,

but the Real-robot doesn't work...
I don't know how to do...

Can anyone help me, pls...

Thank you so much and have a nice day!! 🥹

>>> 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
om/user-attachments/assets/7fb6fad4-d259-4203-9086-bdbc40ba6baf)

thanhtruongphan, 2024-10-29:
I tried with the data 'o 255 255' to serial but nothing happen...
>>> 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

thanhtruongphan, 2024-11-02:
oh, oh, maybe Ubuntu on VMvirtualbox machine can connect properly with SBC,

now I can use teleop_twist_keyboard to control two motors.

but, maybe I have some problem,
**when I run command ```ros2 launch andino_bringup andino_robot.launch.py```**:

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

more detail:
```
[INFO] [launch]: All log files can be found below /home/truongpt/.ros/log/2024-11-02-11-05-19-391756-truongpt-sbc-96943
[INFO] [launch]: Default logging verbosity is set to INFO
[INFO] [robot_state_publisher-1]: process started with pid [97024]
[robot_state_publisher-1] [WARN] [1730520322.065477803] [kdl_parser]: The root link base_link has an inertia specified in the URDF, but KDL does not support a root link with an inertia.  As a workaround, you can add an extra dummy link to your URDF.
[robot_state_publisher-1] [INFO] [1730520322.071813321] [robot_state_publisher]: got segment base_footprint
[robot_state_publisher-1] [INFO] [1730520322.074996867] [robot_state_publisher]: got segment base_link
[robot_state_publisher-1] [INFO] [1730520322.075066514] [robot_state_publisher]: got segment camera_link
[robot_state_publisher-1] [INFO] [1730520322.075105976] [robot_state_publisher]: got segment caster_base_link
[robot_state_publisher-1] [INFO] [1730520322.075141049] [robot_state_publisher]: got segment caster_rotation_link
[robot_state_publisher-1] [INFO] [1730520322.075173660] [robot_state_publisher]: got segment caster_wheel_link
[robot_state_publisher-1] [INFO] [1730520322.075205585] [robot_state_publisher]: got segment left_motor
[robot_state_publisher-1] [INFO] [1730520322.075237066] [robot_state_publisher]: got segment left_wheel
[robot_state_publisher-1] [INFO] [1730520322.075268898] [robot_state_publisher]: got segment right_motor
[robot_state_publisher-1] [INFO] [1730520322.075300379] [robot_state_publisher]: got segment right_wheel
[robot_state_publisher-1] [INFO] [1730520322.075331786] [robot_state_publisher]: got segment rplidar_laser_link
[robot_state_publisher-1] [INFO] [1730520322.075363415] [robot_state_publisher]: got segment second_base_link
[INFO] [v4l2_camera_node-2]: process started with pid [97086]
[INFO] [rplidar_composition-3]: process started with pid [97105]
[v4l2_camera_node-2] [INFO] [1730520325.915706520] [v4l2_camera]: Driver: bm2835 mmal
[v4l2_camera_node-2] [INFO] [1730520325.916024772] [v4l2_camera]: Version: 331683
[v4l2_camera_node-2] [INFO] [1730520325.916058753] [v4l2_camera]: Device: mmal service 16.1
[v4l2_camera_node-2] [INFO] [1730520325.916080919] [v4l2_camera]: Location: platform:bcm2835-v4l2-0
[v4l2_camera_node-2] [INFO] [1730520325.916101271] [v4l2_camera]: Capabilities:
[v4l2_camera_node-2] [INFO] [1730520325.916121659] [v4l2_camera]:   Read/write: YES
[v4l2_camera_node-2] [INFO] [1730520325.916141955] [v4l2_camera]:   Streaming: YES
[v4l2_camera_node-2] [INFO] [1730520325.916184195] [v4l2_camera]: Current pixel format: YUYV @ 640x480
[v4l2_camera_node-2] [INFO] [1730520325.917353745] [v4l2_camera]: Available pixel formats:
[v4l2_camera_node-2] [INFO] [1730520325.917410170] [v4l2_camera]:   YU12 - Planar YUV 4:2:0
[v4l2_camera_node-2] [INFO] [1730520325.917433188] [v4l2_camera]:   YUYV - YUYV 4:2:2
[v4l2_camera_node-2] [INFO] [1730520325.917452965] [v4l2_camera]:   RGB3 - 24-bit RGB 8-8-8
[v4l2_camera_node-2] [INFO] [1730520325.917472632] [v4l2_camera]:   JPEG - JFIF JPEG
[v4l2_camera_node-2] [INFO] [1730520325.917491909] [v4l2_camera]:   H264 - H.264
[v4l2_camera_node-2] [INFO] [1730520325.917511131] [v4l2_camera]:   MJPG - Motion-JPEG
[v4l2_camera_node-2] [INFO] [1730520325.917530279] [v4l2_camera]:   YVYU - YVYU 4:2:2
[v4l2_camera_node-2] [INFO] [1730520325.917549315] [v4l2_camera]:   VYUY - VYUY 4:2:2
[v4l2_camera_node-2] [INFO] [1730520325.917568648] [v4l2_camera]:   UYVY - UYVY 4:2:2
[v4l2_camera_node-2] [INFO] [1730520325.917587481] [v4l2_camera]:   NV12 - Y/CbCr 4:2:0
[v4l2_camera_node-2] [INFO] [1730520325.917606629] [v4l2_camera]:   BGR3 - 24-bit BGR 8-8-8
[v4l2_camera_node-2] [INFO] [1730520325.917625591] [v4l2_camera]:   YV12 - Planar YVU 4:2:0
[v4l2_camera_node-2] [INFO] [1730520325.917644887] [v4l2_camera]:   NV21 - Y/CrCb 4:2:0
[v4l2_camera_node-2] [INFO] [1730520325.917664294] [v4l2_camera]:   RX24 - 32-bit XBGR 8-8-8-8
[v4l2_camera_node-2] [INFO] [1730520325.917684109] [v4l2_camera]: Available controls:
[v4l2_camera_node-2] [INFO] [1730520325.917723200] [v4l2_camera]:   Brightness (1) = 50
[v4l2_camera_node-2] [INFO] [1730520325.917758366] [v4l2_camera]:   Contrast (1) = 0
[v4l2_camera_node-2] [INFO] [1730520325.917790606] [v4l2_camera]:   Saturation (1) = 0
[v4l2_camera_node-2] [INFO] [1730520325.917822847] [v4l2_camera]:   Red Balance (1) = 1000
[v4l2_camera_node-2] [INFO] [1730520325.917853290] [v4l2_camera]:   Blue Balance (1) = 1000
[v4l2_camera_node-2] [INFO] [1730520325.917882790] [v4l2_camera]:   Horizontal Flip (2) = 0
[v4l2_camera_node-2] [INFO] [1730520325.917912104] [v4l2_camera]:   Vertical Flip (2) = 0
[v4l2_camera_node-2] [INFO] [1730520325.917942326] [v4l2_camera]:   Power Line Frequency (3) = 1
[v4l2_camera_node-2] [INFO] [1730520325.917972473] [v4l2_camera]:   Sharpness (1) = 0
[v4l2_camera_node-2] [INFO] [1730520325.918002287] [v4l2_camera]:   Color Effects (3) = 0
[v4l2_camera_node-2] [INFO] [1730520325.918031935] [v4l2_camera]:   Rotate (1) = 0
[v4l2_camera_node-2] [INFO] [1730520325.918061416] [v4l2_camera]:   Color Effects, CbCr (1) = 32896
[v4l2_camera_node-2] [ERROR] [1730520325.918107896] [v4l2_camera]: Failed getting value for control 10027009: Permission denied (13); returning 0!
[v4l2_camera_node-2] [INFO] [1730520325.918183043] [v4l2_camera]:   Codec Controls (6) = 0
[v4l2_camera_node-2] [INFO] [1730520325.918218950] [v4l2_camera]:   Video Bitrate Mode (3) = 0
[v4l2_camera_node-2] [INFO] [1730520325.918250671] [v4l2_camera]:   Video Bitrate (1) = 10000000
[v4l2_camera_node-2] [INFO] [1730520325.918281578] [v4l2_camera]:   Repeat Sequence Header (2) = 0
[v4l2_camera_node-2] [ERROR] [1730520325.918313059] [v4l2_camera]: Failed getting value for control 10029541: Permission denied (13); returning 0!
[v4l2_camera_node-2] [INFO] [1730520325.918335299] [v4l2_camera]:   Force Key Frame (4) = 0
[v4l2_camera_node-2] [INFO] [1730520325.918364613] [v4l2_camera]:   H264 Minimum QP Value (1) = 0
[v4l2_camera_node-2] [INFO] [1730520325.918394872] [v4l2_camera]:   H264 Maximum QP Value (1) = 0
[v4l2_camera_node-2] [INFO] [1730520325.918424445] [v4l2_camera]:   H264 I-Frame Period (1) = 60
[v4l2_camera_node-2] [INFO] [1730520325.918454889] [v4l2_camera]:   H264 Level (3) = 11
[v4l2_camera_node-2] [INFO] [1730520325.918484203] [v4l2_camera]:   H264 Profile (3) = 4
[v4l2_camera_node-2] [ERROR] [1730520325.918514740] [v4l2_camera]: Failed getting value for control 10092545: Permission denied (13); returning 0!
[v4l2_camera_node-2] [INFO] [1730520325.918535684] [v4l2_camera]:   Camera Controls (6) = 0
[v4l2_camera_node-2] [INFO] [1730520325.918564776] [v4l2_camera]:   Auto Exposure (3) = 0
[v4l2_camera_node-2] [INFO] [1730520325.918595294] [v4l2_camera]:   Exposure Time, Absolute (1) = 1000
[v4l2_camera_node-2] [INFO] [1730520325.918625812] [v4l2_camera]:   Exposure, Dynamic Framerate (2) = 0
[v4l2_camera_node-2] [INFO] [1730520325.918656811] [v4l2_camera]:   Auto Exposure, Bias (9) = 12
[v4l2_camera_node-2] [INFO] [1730520325.918686570] [v4l2_camera]:   White Balance, Auto & Preset (3) = 1
[v4l2_camera_node-2] [INFO] [1730520325.918715976] [v4l2_camera]:   Image Stabilization (2) = 0
[v4l2_camera_node-2] [INFO] [1730520325.922449233] [v4l2_camera]:   ISO Sensitivity (9) = 0
[v4l2_camera_node-2] [INFO] [1730520325.922537157] [v4l2_camera]:   ISO Sensitivity, Auto (3) = 1
[v4l2_camera_node-2] [INFO] [1730520325.922574545] [v4l2_camera]:   Exposure, Metering Mode (3) = 0
[v4l2_camera_node-2] [INFO] [1730520325.922610545] [v4l2_camera]:   Scene Mode (3) = 0
[v4l2_camera_node-2] [ERROR] [1730520325.922649173] [v4l2_camera]: Failed getting value for control 10289153: Permission denied (13); returning 0!
[v4l2_camera_node-2] [INFO] [1730520325.922675062] [v4l2_camera]:   JPEG Compression Controls (6) = 0
[v4l2_camera_node-2] [INFO] [1730520325.922707135] [v4l2_camera]:   Compression Quality (1) = 30
[v4l2_camera_node-2] [WARN] [1730520325.927204802] [v4l2_camera_node]: Control type not currently supported: 6, for control: Codec Controls
[v4l2_camera_node-2] [WARN] [1730520325.928066803] [v4l2_camera_node]: Control type not currently supported: 4, for control: Force Key Frame
[v4l2_camera_node-2] [WARN] [1730520325.928623588] [v4l2_camera_node]: Control type not currently supported: 6, for control: Camera Controls
[v4l2_camera_node-2] [WARN] [1730520325.929047116] [v4l2_camera_node]: Control type not currently supported: 9, for control: Auto Exposure, Bias
[v4l2_camera_node-2] [WARN] [1730520325.929344351] [v4l2_camera_node]: Control type not currently supported: 9, for control: ISO Sensitivity
[v4l2_camera_node-2] [WARN] [1730520325.929761638] [v4l2_camera_node]: Control type not currently supported: 6, for control: JPEG Compression Controls
[v4l2_camera_node-2] [INFO] [1730520325.930008948] [v4l2_camera_node]: camera calibration URL: file:///home/truongpt/ws/install/andino_bringup/share/andino_bringup/config/raspicam.yaml
[v4l2_camera_node-2] [WARN] [1730520325.940628174] [v4l2_camera_node]: [mmal_service_16.1] does not match narrow_stereo in file /home/truongpt/ws/install/andino_bringup/share/andino_bringup/config/raspicam.yaml
[v4l2_camera_node-2] [INFO] [1730520325.943830424] [v4l2_camera]: Starting camera
[v4l2_camera_node-2] [ERROR] [1730520325.944354672] [v4l2_camera]: Buffer failure on capture start: Device or resource busy (16)
[rplidar_composition-3] [INFO] [1730520327.068995447] [rplidar_node]: RPLidar running on ROS2 package rplidar_ros. RPLIDAR SDK Version:2.0.0
[rplidar_composition-3] [INFO] [1730520327.134267440] [rplidar_node]: RPLidar S/N: B296ED93C0EA98C6C2E29EF5404C4061
[rplidar_composition-3] [INFO] [1730520327.134446362] [rplidar_node]: Firmware Ver: 1.29
[rplidar_composition-3] [INFO] [1730520327.134490232] [rplidar_node]: Hardware Rev: 7
[rplidar_composition-3] [INFO] [1730520327.185997285] [rplidar_node]: RPLidar health status : 0
[rplidar_composition-3] [INFO] [1730520327.186370926] [rplidar_node]: RPLidar health status : OK.
[rplidar_composition-3] [INFO] [1730520327.186447165] [rplidar_node]: Start
[rplidar_composition-3] [INFO] [1730520328.638723404] [rplidar_node]: current scan mode: Sensitivity, sample rate: 8 Khz, max_distance: 12.0 m, scan frequency:10.0 Hz,
[INFO] [ros2_control_node-4]: process started with pid [97226]
[INFO] [spawner-5]: process started with pid [97228]
[ros2_control_node-4] [WARN] [1730520331.693177195] [controller_manager]: [Deprecated] Passing the robot description parameter directly to the control_manager node is deprecated. Use '~/robot_description' topic from 'robot_state_publisher' instead.
[ros2_control_node-4] [INFO] [1730520331.703916586] [resource_manager]: Loading hardware 'RealRobot'
[ros2_control_node-4] [INFO] [1730520331.724963561] [resource_manager]: Initialize hardware 'RealRobot'
[ros2_control_node-4] [INFO] [1730520331.740330820] [DiffDriveAndino]: On init...
[ros2_control_node-4] [INFO] [1730520331.747156680] [DiffDriveAndino]: Finished On init.
[ros2_control_node-4] [INFO] [1730520331.756812445] [resource_manager]: Successful initialization of hardware 'RealRobot'
[ros2_control_node-4] [INFO] [1730520331.757391136] [resource_manager]: 'configure' hardware 'RealRobot'
[ros2_control_node-4] [INFO] [1730520331.766788592] [DiffDriveAndino]: On configure...
[ros2_control_node-4] [INFO] [1730520331.793089719] [DiffDriveAndino]: Finished Configuration
[ros2_control_node-4] [INFO] [1730520331.793236197] [resource_manager]: Successful 'configure' of hardware 'RealRobot'
[ros2_control_node-4] [INFO] [1730520331.793284085] [resource_manager]: 'activate' hardware 'RealRobot'
[ros2_control_node-4] [INFO] [1730520331.793311029] [DiffDriveAndino]: On activate...
[ros2_control_node-4] [INFO] [1730520331.793332658] [DiffDriveAndino]: Finished Activation
[ros2_control_node-4] [INFO] [1730520331.793359750] [resource_manager]: Successful 'activate' of hardware 'RealRobot'
[ros2_control_node-4] [INFO] [1730520331.866484564] [controller_manager]: update rate is 50 Hz
[ros2_control_node-4] [WARN] [1730520331.871475369] [controller_manager]: No real-time kernel detected on this system. See [https://control.ros.org/master/doc/ros2_control/controller_manager/doc/userdoc.html] for details on how to enable realtime scheduling.
[ros2_control_node-4] Response to e timed out.
[ros2_control_node-4] [INFO] [1730520333.935636652] [controller_manager]: Loading controller 'joint_state_broadcaster'
[spawner-5] [INFO] [1730520334.265061654] [spawner_joint_state_broadcaster]: Loaded joint_state_broadcaster
[ros2_control_node-4] [INFO] [1730520334.276778525] [controller_manager]: Configuring controller 'joint_state_broadcaster'
[ros2_control_node-4] [INFO] [1730520334.277208757] [joint_state_broadcaster]: 'joints' or 'interfaces' parameter is empty. All available state interfaces will be published
[spawner-5] [INFO] [1730520334.386046469] [spawner_joint_state_broadcaster]: Configured and activated joint_state_broadcaster
[INFO] [spawner-5]: process has finished cleanly [pid 97228]
[INFO] [spawner-6]: process started with pid [97314]
[spawner-6] [INFO] [1730520337.325429674] [spawner_diff_controller]: waiting for service /controller_manager/list_controllers to become available...
[ros2_control_node-4] [INFO] [1730520338.356542758] [controller_manager]: Loading controller 'diff_controller'
[spawner-6] [INFO] [1730520338.641385975] [spawner_diff_controller]: Loaded diff_controller
[ros2_control_node-4] [INFO] [1730520338.662279010] [controller_manager]: Configuring controller 'diff_controller'
[spawner-6] [INFO] [1730520338.789621437] [spawner_diff_controller]: Configured and activated diff_controller
[INFO] [spawner-6]: process has finished cleanly [pid 97314]
```

**and when I run command to open slam package ```ros2 launch andino_slam slam_toolbox_online_async.launch.py```**

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

and no Rviz or any GUI is show up...

thanhtruongphan, 2024-11-02:
and when I run command line to open rviz after biringup **```ros2 launch andino_bringup rviz.launch.py```**

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

francocipollone, 2024-11-04:
Hey there @thanhtruongphan , thanks for your interest.

Let's try to understand the context, identify the issue, and then narrow down the problem that you might be facing.

0. If you want to use the simulation at some point, check [andino_gz](https://github.com/Ekumen-OS/andino_gz). That's the recommended simulation (gz_classic is outdated).

1. Were you able to move the real robot? Assuming for the output of the andino_bringup launch it seems that everything is alright, at least no errors were shown.

2. andino_slam's launch file by default is not launching any rivz or GUI visualization ( imagine that you can either launch that on an external laptop or directly in the SBC). You have a `ros2 launch andino_slam rviz.launch.py` for launching only rviz with some convenient setup when doing slam.

3. That issue you mentioned when running "ros2 launch andino_bringup rviz.launch.py" might be related most probably to the fact that `map` is set as fixed frame and the map is not being published. Try changing the fixed frame to base_link and see if you actually see the robot and the wheels are rotating when you rotate the real wheels (to fully see that your set up is ok and for example encoders are correctly working)

thanhtruongphan, 2024-11-04:
hi @francocipollone very happy and thank for your reply. and have a nice day. :1st_place_medal:

now, I have problem with work between SBC-computer and ubuntu laptop. Both is Ubuntu 22.04 and ROS2 humble like the instructions in README.md file, of course Ubuntu mate on Raspi4.

The issue is I can't use the "discovery" feature https://docs.ros.org/en/rolling/Installation/Alternatives/Ubuntu-Development-Setup.html#try-some-examples

I tried https://docs.ros.org/en/humble/Tutorials/Beginner-CLI-Tools/Configuring-ROS2-Environment.html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 but it doesn't work.

I can't listen on SBC from Ubuntu laptop or listen on Ubuntu laptop from SBC. So, I when I run Rviz on Ubuntu laptop, it doesn't show up anything. (I installed Ubuntu dual boot with Windows11 and of course use both Ubuntu on one Wifi)

Have you ever saw that problem? I've reinstalled Ubuntu mate on my SBC and hope it work... :smiling_face_with_tear:

francocipollone, 2024-11-04:
> The issue is I can't use the "discovery" feature https://docs.ros.org/en/rolling/Installation/Alternatives/Ubuntu-Development-Setup.html#try-some-examples

Run a "talker" node in your laptop and and `listener` node on your SBC and vice-versa. See if the communication goes both ways.

Verify that you are not using any ROS_LOCALHOST or ROS_DOMAIN_ID env var on both computers. Later on, if you want to isolate the robot in a particular ROS_DOMAIN_ID you can do it. However if it is your first time doing so in ROS 2 start easy.

If everything is ok and still not working you can see if your router is actually causing some issue. So try using another network: The easiest way is to use your smartphone to set up a wifi network real quick and connect laptop and sbc to that wifi network and see what happens.

thanhtruongphan, 2024-11-04:
yeah, here is env var on mine

>>> 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

I'm reinstalling ubuntu mate on SBC, and I will test again... :jack_o_lantern:

thanhtruongphan, 2024-11-04:
yeah, using Wifi from smartphone helped me to solve problem "talker/listener". Great~ @francocipollone

now when I run **```rosdep install --from-paths src -i -y -r```**

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

result:
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

I don't care it then continue the instructions to install, and finally run the command line **```ros2 launch andino_bringup andino_robot.launch.py```**

it auto close and the error is:

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

help me, pls :1st_place_medal:
-thank you-

thanhtruongphan, 2024-11-04:
camera and lidar and arduino is on, successfully check in https://github.com/Ekumen-OS/andino/tree/humble/andino_hardware :smiling_face_with_tear:

thanhtruongphan, 2024-11-04:
yeah... the problem has been solved by using Wifi share by smartphone.

Thank you so much~ :100:

thanhtruongphan, 2024-11-04:
sorry, i'm new to ubuntu and ROS2.

can i ask a question?

can i use this project on Jetson nano devkit (B01)?
I have a Jetson nano devkit and a research project that works with this Jetson and ROS (ROS2 in case of andino) and uses machine vision with some image processing tasks.

-thanks-

francocipollone, 2024-11-04:
That issue that was shown in the resolved comment seems something with the camera, were you able to solve it? Do you have a camera installed?

> can i use this project on Jetson nano devkit (B01)?

You definitely can, I haven't tried this there but it should be fully compatible code-wise, you might need to make some changes at some point I imagine. However if you go that path it would be great to come back and mention how your experience with Jetson nano was when using it in a Andino.

Thread 276 (2024-11-08):

Arduino code compilation issue

maxxlife, 2024-11-08:
When I try to compile Arduino ino file project from andino/andino_firmware, receive an error. Do you have a list of libraries to add to the Arduino IDE environment?
```
In file included from /home/maxxlife/andino/andino_firmware/src/app.h:32:0,
                 from /home/maxxlife/andino/andino_firmware/src/app.cpp:65:
/home/maxxlife/Arduino/libraries/Adafruit_BNO055/Adafruit_BNO055.h:29:10: fatal error: Adafruit_Sensor.h: No such file or directory
 #include <Adafruit_Sensor.h>
          ^~~~~~~~~~~~~~~~~~~
compilation terminated.
exit status 1

Compilation error: exit status 1
```

francocipollone, 2024-11-08:
Check the readme at `andino_firmware's` package: https://github.com/Ekumen-OS/andino/tree/humble/andino_firmware

maxxlife, 2024-11-09:
> Check the readme at `andino_firmware's` package: https://github.com/Ekumen-OS/andino/tree/humble/andino_firmware
>
> There you will see the path for loading it using arduino IDE or platform io.

Thanks, using terminal command pio I was able to compile it. Could I build a project for Arduino Leonardo?

francocipollone, 2024-12-20:
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

Hey @maxxlife to be honest I haven't tried it with Leonardo. The pinout should match and regarding the interruptions leonardo has a couple of hardware interruptions that are switched, however we mainly use software interruptions in the code. So it SHOULD work from theory.
In case you build it for Leonardo please feel free to comment here with the outcome! All info is welcomed! :D

Closing the issue as it is resolved.

maxxlife, 2024-12-20:
Yes, I was able to build for Leonardo. There is difference in Interrupts names. But it can be reconfigured following the datasheets for Leonardo and Arduino Uno different ATMega controllers. I compiled the code for Leonardo with the updated Interrupt name, but didn't test it.

francocipollone, 2024-12-20:
> Yes, I was able to build for Leonardo. There is difference in Interrupts names. But it can be reconfigured following the datasheets for Leonardo and Arduino Uno different ATMega controllers. I compiled the code for Leonardo with the updated Interrupt name, but didn't test it.

Thanks for closing the loop on that. I appreciate the information :D

maxxlife, 2024-12-20:
> > Yes, I was able to build for Leonardo. There is difference in Interrupts names. But it can be reconfigured following the datasheets for Leonardo and Arduino Uno different ATMega controllers. I compiled the code for Leonardo with the updated Interrupt name, but didn't test it.
>
> Thanks for closing the loop on that. I appreciate the information :D

I will create a PR or feature for that. Currently I'm in the heavy job search process, and also lost paper with all my notes about Interrupts reconfigure during my home move.

Closed 2024-12-20.
