Ekumen-OS/andino/andino_firmware/src/main.cpp

// BSD 3-Clause License
//
// Copyright (c) 2023, Ekumen Inc.
// All rights reserved.
//
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
// 3. Neither the name of the copyright holder nor the names of its
//    contributors may be used to endorse or promote products derived from
//    this software without specific prior written permission.
//
// THIS SOFTWARE IS PROVIDED BY THE COPYRIGHT HOLDERS AND CONTRIBUTORS "AS IS"
// AND ANY EXPRESS OR IMPLIED WARRANTIES, INCLUDING, BUT NOT LIMITED TO, THE
// IMPLIED WARRANTIES OF MERCHANTABILITY AND FITNESS FOR A PARTICULAR PURPOSE ARE
// DISCLAIMED. IN NO EVENT SHALL THE COPYRIGHT HOLDER OR CONTRIBUTORS BE LIABLE
// FOR ANY DIRECT, INDIRECT, INCIDENTAL, SPECIAL, EXEMPLARY, OR CONSEQUENTIAL
// DAMAGES (INCLUDING, BUT NOT LIMITED TO, PROCUREMENT OF SUBSTITUTE GOODS OR
// SERVICES; LOSS OF USE, DATA, OR PROFITS; OR BUSINESS INTERRUPTION) HOWEVER
// CAUSED AND ON ANY THEORY OF LIABILITY, WHETHER IN CONTRACT, STRICT LIABILITY,
// OR TORT (INCLUDING NEGLIGENCE OR OTHERWISE) ARISING IN ANY WAY OUT OF THE USE
// OF THIS SOFTWARE, EVEN IF ADVISED OF THE POSSIBILITY OF SUCH DAMAGE.
#include <Arduino.h>

#include "andino/app/app.h"
#include "andino/board.h"
#include "andino/bsp/arduino/clock_arduino.h"
#include "andino/bsp/arduino/digital_out_arduino.h"
#include "andino/bsp/arduino/imu_arduino.h"
#include "andino/bsp/arduino/interrupt_in_arduino.h"
#include "andino/bsp/arduino/pwm_out_arduino.h"
#include "andino/bsp/arduino/serial_stream_arduino.h"

// BSP implementations.
static andino::ClockArduino sys_clock;
static andino::SerialStreamArduino serial_stream(andino::Board::kSerialBaudRate);
static andino::DigitalOutArduino left_motor_enable(andino::Board::kLeftMotorEnableGpioPin);
static andino::PwmOutArduino left_motor_forward(andino::Board::kLeftMotorForwardGpioPin);
static andino::PwmOutArduino left_motor_backward(andino::Board::kLeftMotorBackwardGpioPin);
static andino::DigitalOutArduino right_motor_enable(andino::Board::kRightMotorEnableGpioPin);
static andino::PwmOutArduino right_motor_forward(andino::Board::kRightMotorForwardGpioPin);
static andino::PwmOutArduino right_motor_backward(andino::Board::kRightMotorBackwardGpioPin);
static andino::InterruptInArduino left_encoder_a(andino::Board::kLeftEncoderChannelAGpioPin);
static andino::InterruptInArduino left_encoder_b(andino::Board::kLeftEncoderChannelBGpioPin);
static andino::InterruptInArduino right_encoder_a(andino::Board::kRightEncoderChannelAGpioPin);
static andino::InterruptInArduino right_encoder_b(andino::Board::kRightEncoderChannelBGpioPin);
static andino::ImuArduino imu;

// Main application.
static andino::App app(andino::kAppConfig, sys_clock, serial_stream, left_motor_enable,
                       left_motor_forward, left_motor_backward, right_motor_enable,
                       right_motor_forward, right_motor_backward, left_encoder_a, left_encoder_b,
                       right_encoder_a, right_encoder_b, imu);

/// @brief Application entry point.
///
/// @return Execution final status (never reached).
int main(void) {
  // Required by Arduino libraries to work.
  init();

  // Application configuration.
  app.setup();

  // Application main run loop.
  while (1) {
    app.loop();

    // Required by Arduino libraries to work.
    if (serialEventRun) {
      serialEventRun();
    }
  }

  return 0;
}
