Ekumen-OS/andino/andino_firmware/src/app.cpp

// Code in this file is inspired by:
// https://github.com/hbrobotics/ros_arduino_bridge/blob/indigo-devel/ros_arduino_firmware/src/libraries/ROSArduinoBridge/ROSArduinoBridge.ino
//
// ----------------------------------------------------------------------------
// ros_arduino_bridge's license follows:
//
// Software License Agreement (BSD License)
//
// Copyright (c) 2012, Patrick Goebel.
// All rights reserved.
//
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
//   * Redistributions of source code must retain the above copyright
//     notice, this list of conditions and the following disclaimer.
//   * Redistributions in binary form must reproduce the above
//     copyright notice, this list of conditions and the following
//     disclaimer in the documentation and/or other materials provided
//     with the distribution.
//
// THIS SOFTWARE IS PROVIDED BY THE COPYRIGHT HOLDERS AND CONTRIBUTORS
// "AS IS" AND ANY EXPRESS OR IMPLIED WARRANTIES, INCLUDING, BUT NOT
// LIMITED TO, THE IMPLIED WARRANTIES OF MERCHANTABILITY AND FITNESS
// FOR A PARTICULAR PURPOSE ARE DISCLAIMED. IN NO EVENT SHALL THE
// COPYRIGHT OWNER OR CONTRIBUTORS BE LIABLE FOR ANY DIRECT, INDIRECT,
// INCIDENTAL, SPECIAL, EXEMPLARY, OR CONSEQUENTIAL DAMAGES (INCLUDING,
// BUT NOT LIMITED TO, PROCUREMENT OF SUBSTITUTE GOODS OR SERVICES;
// LOSS OF USE, DATA, OR PROFITS; OR BUSINESS INTERRUPTION) HOWEVER
// CAUSED AND ON ANY THEORY OF LIABILITY, WHETHER IN CONTRACT, STRICT
// LIABILITY, OR TORT (INCLUDING NEGLIGENCE OR OTHERWISE) ARISING IN
// ANY WAY OUT OF THE USE OF THIS SOFTWARE, EVEN IF ADVISED OF THE
// POSSIBILITY OF SUCH DAMAGE.

// BSD 3-Clause License
//
// Copyright (c) 2023, Ekumen Inc.
// All rights reserved.
//
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
// 3. Neither the name of the copyright holder nor the names of its
//    contributors may be used to endorse or promote products derived from
//    this software without specific prior written permission.
//
// THIS SOFTWARE IS PROVIDED BY THE COPYRIGHT HOLDERS AND CONTRIBUTORS "AS IS"
// AND ANY EXPRESS OR IMPLIED WARRANTIES, INCLUDING, BUT NOT LIMITED TO, THE
// IMPLIED WARRANTIES OF MERCHANTABILITY AND FITNESS FOR A PARTICULAR PURPOSE ARE
// DISCLAIMED. IN NO EVENT SHALL THE COPYRIGHT HOLDER OR CONTRIBUTORS BE LIABLE
// FOR ANY DIRECT, INDIRECT, INCIDENTAL, SPECIAL, EXEMPLARY, OR CONSEQUENTIAL
// DAMAGES (INCLUDING, BUT NOT LIMITED TO, PROCUREMENT OF SUBSTITUTE GOODS OR
// SERVICES; LOSS OF USE, DATA, OR PROFITS; OR BUSINESS INTERRUPTION) HOWEVER
// CAUSED AND ON ANY THEORY OF LIABILITY, WHETHER IN CONTRACT, STRICT LIABILITY,
// OR TORT (INCLUDING NEGLIGENCE OR OTHERWISE) ARISING IN ANY WAY OUT OF THE USE
// OF THIS SOFTWARE, EVEN IF ADVISED OF THE POSSIBILITY OF SUCH DAMAGE.
#include "app.h"

#include <Adafruit_BNO055.h>
#include <Adafruit_Sensor.h>
#include <Arduino.h>
#include <Wire.h>
#include <utility/imumaths.h>

#include "commands.h"
#include "constants.h"
#include "andino/bsp/digital_out_arduino.h"
#include "andino/drivers/encoder.h"
#include "hw.h"
#include "andino/bsp/interrupt_in_arduino.h"
#include "andino/drivers/motor.h"
#include "pid.h"
#include "andino/bsp/pwm_out_arduino.h"
#include "andino/bsp/serial_stream_arduino.h"
#include "shell.h"

namespace andino {

SerialStreamArduino App::serial_stream_;

Shell App::shell_;

DigitalOutArduino App::left_motor_enable_digital_out_(Hw::kLeftMotorEnableGpioPin);
PwmOutArduino App::left_motor_forward_pwm_out_(Hw::kLeftMotorForwardGpioPin);
PwmOutArduino App::left_motor_backward_pwm_out_(Hw::kLeftMotorBackwardGpioPin);
Motor App::left_motor_(&left_motor_enable_digital_out_, &left_motor_forward_pwm_out_,
                       &left_motor_backward_pwm_out_);

DigitalOutArduino App::right_motor_enable_digital_out_(Hw::kRightMotorEnableGpioPin);
PwmOutArduino App::right_motor_forward_pwm_out_(Hw::kRightMotorForwardGpioPin);
PwmOutArduino App::right_motor_backward_pwm_out_(Hw::kRightMotorBackwardGpioPin);
Motor App::right_motor_(&right_motor_enable_digital_out_, &right_motor_forward_pwm_out_,
                        &right_motor_backward_pwm_out_);

InterruptInArduino App::left_encoder_channel_a_interrupt_in_(Hw::kLeftEncoderChannelAGpioPin);
InterruptInArduino App::left_encoder_channel_b_interrupt_in_(Hw::kLeftEncoderChannelBGpioPin);
Encoder App::left_encoder_(&left_encoder_channel_a_interrupt_in_,
                           &left_encoder_channel_b_interrupt_in_);

InterruptInArduino App::right_encoder_channel_a_interrupt_in_(Hw::kRightEncoderChannelAGpioPin);
InterruptInArduino App::right_encoder_channel_b_interrupt_in_(Hw::kRightEncoderChannelBGpioPin);
Encoder App::right_encoder_(&right_encoder_channel_a_interrupt_in_,
                            &right_encoder_channel_b_interrupt_in_);

Pid App::left_pid_controller_(Constants::kPidKp, Constants::kPidKd, Constants::kPidKi,
                              Constants::kPidKo, -Constants::kPwmMax, Constants::kPwmMax);
Pid App::right_pid_controller_(Constants::kPidKp, Constants::kPidKd, Constants::kPidKi,
                               Constants::kPidKo, -Constants::kPwmMax, Constants::kPwmMax);

unsigned long App::last_pid_computation_{0};

unsigned long App::last_set_motors_speed_cmd_{0};

bool App::is_imu_connected{false};

Adafruit_BNO055 App::bno055_imu_{/*sensorID=*/55, BNO055_ADDRESS_A, &Wire};

void App::setup() {
  // Required by Arduino libraries to work.
  init();

  serial_stream_.begin(Constants::kBaudrate);

  left_encoder_.begin();
  right_encoder_.begin();

  left_motor_.begin();
  left_motor_.enable(true);
  right_motor_.begin();
  right_motor_.enable(true);

  left_pid_controller_.reset(left_encoder_.read());
  right_pid_controller_.reset(right_encoder_.read());

  // Initialize command shell.
  shell_.set_serial_stream(&serial_stream_);
  shell_.set_default_callback(cmd_unknown_cb);
  shell_.register_command(Commands::kReadAnalogGpio, cmd_read_analog_gpio_cb);
  shell_.register_command(Commands::kReadDigitalGpio, cmd_read_digital_gpio_cb);
  shell_.register_command(Commands::kReadEncoders, cmd_read_encoders_cb);
  shell_.register_command(Commands::kResetEncoders, cmd_reset_encoders_cb);
  shell_.register_command(Commands::kSetMotorsSpeed, cmd_set_motors_speed_cb);
  shell_.register_command(Commands::kSetMotorsPwm, cmd_set_motors_pwm_cb);
  shell_.register_command(Commands::kSetPidsTuningGains, cmd_set_pid_tuning_gains_cb);
  shell_.register_command(Commands::kGetIsImuConnected, cmd_get_is_imu_connected_cb);
  shell_.register_command(Commands::kReadEncodersAndImu, cmd_read_encoders_and_imu_cb);

  // Initialize IMU sensor.
  if (bno055_imu_.begin()) {
    bno055_imu_.setExtCrystalUse(true);
    is_imu_connected = true;
  }
}

void App::loop() {
  // Process command prompt input.
  shell_.process_input();

  // Compute PID output at the configured rate.
  if ((millis() - last_pid_computation_) > Constants::kPidPeriod) {
    last_pid_computation_ = millis();
    adjust_motors_speed();
  }

  // Stop the motors if auto-stop interval has been reached.
  if ((millis() - last_set_motors_speed_cmd_) > Constants::kAutoStopWindow) {
    last_set_motors_speed_cmd_ = millis();
    stop_motors();
  }

  // Required by Arduino libraries to work.
  if (serialEventRun) {
    serialEventRun();
  }
}

void App::adjust_motors_speed() {
  int left_motor_speed = 0;
  int right_motor_speed = 0;
  left_pid_controller_.compute(left_encoder_.read(), left_motor_speed);
  right_pid_controller_.compute(right_encoder_.read(), right_motor_speed);
  if (left_pid_controller_.enabled()) {
    left_motor_.set_speed(left_motor_speed);
  }
  if (right_pid_controller_.enabled()) {
    right_motor_.set_speed(right_motor_speed);
  }
}

void App::stop_motors() {
  left_motor_.set_speed(0);
  right_motor_.set_speed(0);
  left_pid_controller_.disable();
  right_pid_controller_.disable();
}

void App::cmd_unknown_cb(int, char**) { Serial.println("Unknown command."); }

void App::cmd_read_analog_gpio_cb(int argc, char** argv) {
  if (argc < 2) {
    return;
  }

  const int pin = atoi(argv[1]);
  Serial.println(analogRead(pin));
}

void App::cmd_read_digital_gpio_cb(int argc, char** argv) {
  if (argc < 2) {
    return;
  }

  const int pin = atoi(argv[1]);
  Serial.println(digitalRead(pin));
}

void App::cmd_read_encoders_cb(int, char**) {
  Serial.print(left_encoder_.read());
  Serial.print(" ");
  Serial.println(right_encoder_.read());
}

void App::cmd_reset_encoders_cb(int, char**) {
  left_encoder_.reset();
  right_encoder_.reset();
  left_pid_controller_.reset(left_encoder_.read());
  right_pid_controller_.reset(right_encoder_.read());
  Serial.println("OK");
}

void App::cmd_set_motors_speed_cb(int argc, char** argv) {
  if (argc < 3) {
    return;
  }

  const int left_motor_speed = atoi(argv[1]);
  const int right_motor_speed = atoi(argv[2]);

  // Reset the auto stop timer.
  last_set_motors_speed_cmd_ = millis();
  if (left_motor_speed == 0 && right_motor_speed == 0) {
    left_motor_.set_speed(0);
    right_motor_.set_speed(0);
    left_pid_controller_.reset(left_encoder_.read());
    right_pid_controller_.reset(right_encoder_.read());
    left_pid_controller_.disable();
    right_pid_controller_.disable();
  } else {
    left_pid_controller_.enable();
    right_pid_controller_.enable();
  }

  // The target speeds are in ticks per second, so we need to convert them to ticks per
  // Constants::kPidRate.
  left_pid_controller_.set_setpoint(left_motor_speed / Constants::kPidRate);
  right_pid_controller_.set_setpoint(right_motor_speed / Constants::kPidRate);
  Serial.println("OK");
}

void App::cmd_set_motors_pwm_cb(int argc, char** argv) {
  if (argc < 3) {
    return;
  }

  const int left_motor_pwm = atoi(argv[1]);
  const int right_motor_pwm = atoi(argv[2]);

  left_pid_controller_.reset(left_encoder_.read());
  right_pid_controller_.reset(right_encoder_.read());
  // Sneaky way to temporarily disable the PID.
  left_pid_controller_.disable();
  right_pid_controller_.disable();

  // Reset the auto stop timer.
  last_set_motors_speed_cmd_ = millis();

  left_motor_.set_speed(left_motor_pwm);
  right_motor_.set_speed(right_motor_pwm);
  Serial.println("OK");
}

void App::cmd_set_pid_tuning_gains_cb(int argc, char** argv) {
  // TODO(jballoffet): Refactor to expect command multiple arguments.
  if (argc < 2) {
    return;
  }

  static constexpr int kSizePidArgs{4};
  int i = 0;
  char arg[20];
  char* str;
  int pid_args[kSizePidArgs]{0, 0, 0, 0};

  // Example: "u 30:20:10:50".
  strcpy(arg, argv[1]);
  char* p = arg;
  while ((str = strtok_r(p, ":", &p)) != NULL && i < kSizePidArgs) {
    pid_args[i] = atoi(str);
    i++;
  }
  left_pid_controller_.set_tunings(pid_args[0], pid_args[1], pid_args[2], pid_args[3]);
  right_pid_controller_.set_tunings(pid_args[0], pid_args[1], pid_args[2], pid_args[3]);
  Serial.print("PID Updated: ");
  Serial.print(pid_args[0]);
  Serial.print(" ");
  Serial.print(pid_args[1]);
  Serial.print(" ");
  Serial.print(pid_args[2]);
  Serial.print(" ");
  Serial.println(pid_args[3]);
  Serial.println("OK");
}

void App::cmd_get_is_imu_connected_cb(int, char**) { Serial.println(is_imu_connected); }

void App::cmd_read_encoders_and_imu_cb(int, char**) {
  Serial.print(left_encoder_.read());
  Serial.print(" ");
  Serial.print(right_encoder_.read());
  Serial.print(" ");

  // Retrieve absolute orientation (quaternion). See
  // https://learn.adafruit.com/adafruit-bno055-absolute-orientation-sensor/overview for further
  // information.
  imu::Quaternion orientation = bno055_imu_.getQuat();
  Serial.print(orientation.x(), 4);
  Serial.print(" ");
  Serial.print(orientation.y(), 4);
  Serial.print(" ");
  Serial.print(orientation.z(), 4);
  Serial.print(" ");
  Serial.print(orientation.w(), 4);
  Serial.print(" ");

  // Retrieve angular velocity (rad/s). See
  // https://learn.adafruit.com/adafruit-bno055-absolute-orientation-sensor/overview for further
  // information.
  imu::Vector<3> angular_velocity = bno055_imu_.getVector(Adafruit_BNO055::VECTOR_GYROSCOPE);
  Serial.print(angular_velocity.x());
  Serial.print(" ");
  Serial.print(angular_velocity.y());
  Serial.print(" ");
  Serial.print(angular_velocity.z());
  Serial.print(" ");

  // Retrieve linear acceleration (m/s^2). See
  // https://learn.adafruit.com/adafruit-bno055-absolute-orientation-sensor/overview for further
  // information.
  imu::Vector<3> linear_acceleration = bno055_imu_.getVector(Adafruit_BNO055::VECTOR_LINEARACCEL);
  Serial.print(linear_acceleration.x());
  Serial.print(" ");
  Serial.print(linear_acceleration.y());
  Serial.print(" ");
  Serial.print(linear_acceleration.z());
}

}  // namespace andino
