Ekumen-OS/andino/andino_firmware/src/app/shell.cpp

// BSD 3-Clause License
//
// Copyright (c) 2023, Ekumen Inc.
// All rights reserved.
//
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
// 3. Neither the name of the copyright holder nor the names of its
//    contributors may be used to endorse or promote products derived from
//    this software without specific prior written permission.
//
// THIS SOFTWARE IS PROVIDED BY THE COPYRIGHT HOLDERS AND CONTRIBUTORS "AS IS"
// AND ANY EXPRESS OR IMPLIED WARRANTIES, INCLUDING, BUT NOT LIMITED TO, THE
// IMPLIED WARRANTIES OF MERCHANTABILITY AND FITNESS FOR A PARTICULAR PURPOSE ARE
// DISCLAIMED. IN NO EVENT SHALL THE COPYRIGHT HOLDER OR CONTRIBUTORS BE LIABLE
// FOR ANY DIRECT, INDIRECT, INCIDENTAL, SPECIAL, EXEMPLARY, OR CONSEQUENTIAL
// DAMAGES (INCLUDING, BUT NOT LIMITED TO, PROCUREMENT OF SUBSTITUTE GOODS OR
// SERVICES; LOSS OF USE, DATA, OR PROFITS; OR BUSINESS INTERRUPTION) HOWEVER
// CAUSED AND ON ANY THEORY OF LIABILITY, WHETHER IN CONTRACT, STRICT LIABILITY,
// OR TORT (INCLUDING NEGLIGENCE OR OTHERWISE) ARISING IN ANY WAY OUT OF THE USE
// OF THIS SOFTWARE, EVEN IF ADVISED OF THE POSSIBILITY OF SUCH DAMAGE.
#include "andino/app/shell.h"

#include <stdio.h>
#include <string.h>

namespace andino {

void Shell::set_serial_stream(const SerialStream* serial_stream) {
  serial_stream_ = serial_stream;
}

void Shell::set_default_callback(CommandCallback callback, void* context) {
  default_callback_ = callback;
  default_callback_context_ = context;
}

bool Shell::register_command(const char* name, CommandCallback callback, void* context) {
  if (commands_count_ >= kCommandsMax || name == nullptr || callback == nullptr) {
    return false;
  }

  // The name, including its null terminator, must fit in the registry entry. Otherwise it would be
  // silently truncated and the command would never match.
  const size_t name_length = strlen(name);
  if (name_length == 0 || name_length >= sizeof(Command::name)) {
    return false;
  }

  // A duplicated name would be unreachable, since the first registered command always matches.
  for (size_t i = 0; i < commands_count_; i++) {
    if (strcmp(name, commands_[i].name) == 0) {
      return false;
    }
  }

  Command command;
  snprintf(command.name, sizeof(command.name), "%s", name);
  command.callback = callback;
  command.context = context;
  commands_[commands_count_++] = command;
  return true;
}

void Shell::process_input() {
  while (serial_stream_->available() > 0) {
    // read() only returns -1 when no data is available, which the available() check above rules
    // out, so the returned byte always fits in a char.
    const char input = static_cast<char>(serial_stream_->read());

    switch (input) {
      case '\r':
        if (discarding_) {
          // The message overflowed the buffer, so it was dropped.
          serial_stream_->println("Command too long.");
          discarding_ = false;
        } else {
          // Terminate command prompt message and parse it.
          message_buffer_[message_index_++] = '\0';
          parse_message();
        }
        // Reset message buffer.
        message_index_ = 0;
        break;

      case '\n':
        // Ignore newline characters.
        break;

      default:
        if (discarding_) {
          break;
        }
        // Prevent buffer overflow, keeping room for the null terminator. The rest of the message
        // is discarded up to the next command terminator.
        if (message_index_ >= kCommandPromptLengthMax - 1) {
          discarding_ = true;
          message_index_ = 0;
          break;
        }
        message_buffer_[message_index_++] = input;
        break;
    }
  }
}

void Shell::parse_message() {
  char* argv[kCommandArgMax];
  int argc = 0;
  char* saveptr = nullptr;

  argv[argc] = strtok_r(message_buffer_, " ", &saveptr);
  while (argc < (kCommandArgMax - 1) && argv[argc] != NULL) {
    argv[++argc] = strtok_r(NULL, " ", &saveptr);
  }

  // Ignore empty messages.
  if (argc == 0) {
    return;
  }

  execute_callback(argc, argv);
}

void Shell::execute_callback(int argc, char** argv) {
  for (size_t i = 0; i < commands_count_; i++) {
    if (!strcmp(argv[0], commands_[i].name)) {
      commands_[i].callback(commands_[i].context, argc, argv);
      return;
    }
  }

  // Unknown command received, executing default callback.
  if (default_callback_ != nullptr) {
    default_callback_(default_callback_context_, argc, argv);
  }
}

}  // namespace andino
