Ekumen-OS/andino/andino_firmware/test/drivers/test_encoder/encoder_test.cpp

// BSD 3-Clause License
//
// Copyright (c) 2024, Ekumen Inc.
// All rights reserved.
//
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
// 3. Neither the name of the copyright holder nor the names of its
//    contributors may be used to endorse or promote products derived from
//    this software without specific prior written permission.
//
// THIS SOFTWARE IS PROVIDED BY THE COPYRIGHT HOLDERS AND CONTRIBUTORS "AS IS"
// AND ANY EXPRESS OR IMPLIED WARRANTIES, INCLUDING, BUT NOT LIMITED TO, THE
// IMPLIED WARRANTIES OF MERCHANTABILITY AND FITNESS FOR A PARTICULAR PURPOSE ARE
// DISCLAIMED. IN NO EVENT SHALL THE COPYRIGHT HOLDER OR CONTRIBUTORS BE LIABLE
// FOR ANY DIRECT, INDIRECT, INCIDENTAL, SPECIAL, EXEMPLARY, OR CONSEQUENTIAL
// DAMAGES (INCLUDING, BUT NOT LIMITED TO, PROCUREMENT OF SUBSTITUTE GOODS OR
// SERVICES; LOSS OF USE, DATA, OR PROFITS; OR BUSINESS INTERRUPTION) HOWEVER
// CAUSED AND ON ANY THEORY OF LIABILITY, WHETHER IN CONTRACT, STRICT LIABILITY,
// OR TORT (INCLUDING NEGLIGENCE OR OTHERWISE) ARISING IN ANY WAY OUT OF THE USE
// OF THIS SOFTWARE, EVEN IF ADVISED OF THE POSSIBILITY OF SUCH DAMAGE.
#include "andino/drivers/encoder.h"

#include <gmock/gmock.h>
#include <gtest/gtest.h>

#include "andino/hal/interrupt_in.h"

namespace andino {
namespace test {
namespace {

using ::testing::_;
using ::testing::Return;

class MockInterruptIn : public andino::InterruptIn {
 public:
  MockInterruptIn() = default;
  MOCK_METHOD(void, begin, (), (const, override));
  MOCK_METHOD(int, read, (), (const, override));
  MOCK_METHOD(void, attach, (andino::InterruptIn::InterruptCallback callback), (const, override));
};

class EncoderTest : public testing::Test {
 protected:
  /// @brief Initializes the encoder and captures the callback attached to its channels, which the
  /// tests invoke to simulate a channels transition.
  void initialize_encoder() {
    ON_CALL(channel_a_interrupt_in_, attach(_))
        .WillByDefault(::testing::SaveArg<0>(&channel_callback_));
    ON_CALL(channel_b_interrupt_in_, attach(_))
        .WillByDefault(::testing::SaveArg<0>(&channel_callback_));

    encoder_.begin();
    ASSERT_NE(channel_callback_, nullptr);
  }

  ::testing::NiceMock<MockInterruptIn> channel_a_interrupt_in_;
  ::testing::NiceMock<MockInterruptIn> channel_b_interrupt_in_;
  andino::Encoder encoder_{&channel_a_interrupt_in_, &channel_b_interrupt_in_};
  andino::InterruptIn::InterruptCallback channel_callback_{nullptr};
};

TEST_F(EncoderTest, Initialize) {
  andino::InterruptIn::InterruptCallback channel_a_callback{nullptr};
  andino::InterruptIn::InterruptCallback channel_b_callback{nullptr};

  EXPECT_CALL(channel_a_interrupt_in_, begin()).Times(1);
  EXPECT_CALL(channel_b_interrupt_in_, begin()).Times(1);
  EXPECT_CALL(channel_a_interrupt_in_, attach(_))
      .Times(1)
      .WillOnce(::testing::SaveArg<0>(&channel_a_callback));
  EXPECT_CALL(channel_b_interrupt_in_, attach(_))
      .Times(1)
      .WillOnce(::testing::SaveArg<0>(&channel_b_callback));

  encoder_.begin();

  // Current implementation requires both channels to call the same callback function.
  EXPECT_NE(channel_a_callback, nullptr);
  EXPECT_NE(channel_b_callback, nullptr);
  EXPECT_EQ(channel_a_callback, channel_b_callback);
}

TEST_F(EncoderTest, ReleasesItsCallbackWrapperUponDestruction) {
  // Only two instances can be initialized at a time, so an initialized instance going out of
  // scope must release its callback wrapper for a later instance to take.
  initialize_encoder();

  {
    ::testing::NiceMock<MockInterruptIn> second_channel_a;
    ::testing::NiceMock<MockInterruptIn> second_channel_b;
    andino::Encoder second_encoder{&second_channel_a, &second_channel_b};
    second_encoder.begin();
  }

  ::testing::NiceMock<MockInterruptIn> third_channel_a;
  ::testing::NiceMock<MockInterruptIn> third_channel_b;
  andino::Encoder third_encoder{&third_channel_a, &third_channel_b};

  // The wrapper released by the second instance is taken by the third one.
  EXPECT_CALL(third_channel_a, attach(_)).Times(1);
  EXPECT_CALL(third_channel_b, attach(_)).Times(1);

  third_encoder.begin();
}

TEST_F(EncoderTest, ReadIncreasingTicksCount) {
  initialize_encoder();

  EXPECT_CALL(channel_a_interrupt_in_, read())
      .Times(4)
      .WillOnce(Return(0))
      .WillOnce(Return(1))
      .WillOnce(Return(1))
      .WillOnce(Return(0));
  EXPECT_CALL(channel_b_interrupt_in_, read())
      .Times(4)
      .WillOnce(Return(0))
      .WillOnce(Return(0))
      .WillOnce(Return(1))
      .WillOnce(Return(1));

  EXPECT_EQ(encoder_.read(), 0);
  channel_callback_();
  EXPECT_EQ(encoder_.read(), 0);
  channel_callback_();
  EXPECT_EQ(encoder_.read(), 1);
  channel_callback_();
  EXPECT_EQ(encoder_.read(), 2);
  channel_callback_();
  EXPECT_EQ(encoder_.read(), 3);
}

TEST_F(EncoderTest, ReadDecreasingTicksCount) {
  initialize_encoder();

  EXPECT_CALL(channel_a_interrupt_in_, read())
      .Times(4)
      .WillOnce(Return(0))
      .WillOnce(Return(0))
      .WillOnce(Return(1))
      .WillOnce(Return(1));
  EXPECT_CALL(channel_b_interrupt_in_, read())
      .Times(4)
      .WillOnce(Return(0))
      .WillOnce(Return(1))
      .WillOnce(Return(1))
      .WillOnce(Return(0));

  EXPECT_EQ(encoder_.read(), 0);
  channel_callback_();
  EXPECT_EQ(encoder_.read(), 0);
  channel_callback_();
  EXPECT_EQ(encoder_.read(), -1);
  channel_callback_();
  EXPECT_EQ(encoder_.read(), -2);
  channel_callback_();
  EXPECT_EQ(encoder_.read(), -3);
}

TEST_F(EncoderTest, ReadChannelsDigitalValues) {
  EXPECT_CALL(channel_a_interrupt_in_, read()).Times(1).WillOnce(Return(1));
  EXPECT_CALL(channel_b_interrupt_in_, read()).Times(1).WillOnce(Return(0));

  EXPECT_EQ(encoder_.read_channel_a(), 1);
  EXPECT_EQ(encoder_.read_channel_b(), 0);
}

TEST_F(EncoderTest, ResetTicksCount) {
  initialize_encoder();

  EXPECT_CALL(channel_a_interrupt_in_, read())
      .Times(3)
      .WillOnce(Return(0))
      .WillOnce(Return(1))
      .WillOnce(Return(1));
  EXPECT_CALL(channel_b_interrupt_in_, read())
      .Times(3)
      .WillOnce(Return(0))
      .WillOnce(Return(0))
      .WillOnce(Return(1));

  EXPECT_EQ(encoder_.read(), 0);
  channel_callback_();
  EXPECT_EQ(encoder_.read(), 0);
  channel_callback_();
  EXPECT_EQ(encoder_.read(), 1);
  channel_callback_();
  EXPECT_EQ(encoder_.read(), 2);
  encoder_.reset();
  EXPECT_EQ(encoder_.read(), 0);
}

}  // namespace
}  // namespace test
}  // namespace andino

int main(int argc, char** argv) {
  ::testing::InitGoogleTest(&argc, argv);
  if (RUN_ALL_TESTS()) {
  }

  // Always return zero-code and allow PlatformIO to parse results.
  return 0;
}
