Ekumen-OS/andino/(commit log)

2024-12-20 Relay stamped cmd vel (#282)
    * Remap velocity command topic and add relay node
    * Use Stamped message for velocity commands
    ---------
2026-08-03 [andino_firmware] Add drivers directory and move files (#320)
2026-08-03 [andino_firmware] Decouple HAL interfaces from physical pin members (#323)
2026-08-03 [andino_firmware] Add Clock HAL and Arduino implementation (#324)
2026-08-03 Integrate pre-commit hooks to automate formatting and style linting (#327)
    [CPPLINT.cfg]
2026-08-03 [andino_firmware] Fix several formatting and style linting issues (#328)
    [app.cpp, app.h, clock_arduino.cpp, digital_out_arduino.cpp, encoder.cpp, interrupt_in_arduino.cpp]
2026-08-03 [andino_firmware] Fix all pending pre-commit checks and style linting issues (#329)
    [CPPLINT.cfg]
2026-09-11 Split MotorDriver into Mcu interface and SerialMcu (#340)
2026-09-11 Add -Wconversion and -Wsign-conversion and fix resulting issues (#333)
    [app.cpp, app.h, digital_out_arduino.cpp, encoder.cpp]
2026-09-11 [andino_firmware] Add static analysis to CI and fix cppcheck findings (#334)
    * Scope compiler warning flags to project source and add stricter checks
    * Add -Wconversion and -Wsign-conversion and fix resulting issues
    * Add static analysis to CI and fix cppcheck findings
    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
    [app.h, shell.cpp]
2026-09-11 Add IMU HAL interface to decouple App from Adafruit BNO055 (#335)
2026-09-11 Decouple App from Arduino's runloop and Serial global (#336)
2026-09-11 Change 'd' command to read encoder digital input values (#337)
2026-09-11 Refactor PID tuning gains command to use multiple arguments (#339)
2026-09-15 Release the encoder callback wrapper upon destruction (#342)
2026-10-19 [andino_firmware] Reject non-positive PID output gain (#347)
    The PID output gain (ko) is used as a divisor, so a value of zero caused a
    division by zero. Reply with an invalid arguments error for ko <= 0 and fix
    the README example, which used ko=0.
2026-10-19 [andino_firmware] Clean up App, Pid and Encoder code quality (#348)
    - Extract reset_pids() and disable_pids() helpers to remove the repeated
    per-wheel PID reset/disable sequences in App.
    - Rename is_imu_connected to is_imu_connected_ to follow the member naming
    convention.
    - Mark Pid::enabled() and Encoder::read() as const.
    - Read the clock once per App::loop() iteration so both timeouts use the
    same instant.
2026-10-19 [andino_firmware] Use fixed-width integer types in PID and encoder code (#350)
    On AVR `int` is 16 bits while on desktop it is 32 bits, so the PID and
    encoder code behaved differently on the target and in unit tests.
    - Use int16_t/int32_t for the Pid and Encoder members and interfaces,
    matching the widths used on AVR.
    - Compute the PID derivative term in 32 bits explicitly so it no longer
    depends on the platform `int` width.
    - Make App::parse_int parse into an int16_t and reject out-of-range values
    instead of silently truncating them.
    - Make Constants::kPidRate an int32_t so the setpoint conversion narrows
    explicitly on every platform.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
2026-10-19 [ci] Add Dependabot configuration (#351)
    Track updates for the GitHub Actions used by the workflows and for the
    firmware development Docker image, on a monthly schedule.
2026-10-19 [andino_firmware] Pin the Adafruit library versions (#352)
    Pin the Adafruit libraries used by the IMU driver to the versions currently
    in use, so a new upstream release can't unexpectedly break the firmware
    build.
2026-10-19 [andino_firmware] Remove the unused Arduino IDE sketch file (#353)
    The firmware is built with PlatformIO, and src/main.cpp defines its own
    main(), so the empty andino_firmware.ino sketch is no longer used. Remove it
    along with its install rule in CMakeLists.txt and the outdated Arduino IDE
    instructions in the README.
2026-10-19 [andino_firmware] Move the PWM limits and the baud rate out of Constants (#362)
    The Constants struct mixed settings that belong to different modules, which
    couples them and leaves their ownership unclear. Start moving them to their
    owners:
    - Make Motor::kMaxSpeed public and use it as the PID output limit, instead
    of keeping a second copy of the same PWM range in Constants. Remove the
    unused kPwmMin.
    - Set the serial baud rate when creating the serial stream in main.cpp, and
    remove it from the SerialStream HAL interface (begin() takes no argument),
    since it is a transport detail that the application shouldn't know.
2026-10-19 [andino_firmware] Make the PID own its gains, rate and speed conversion (#363)
    The PID unit (ticks per computation period) leaked into the application,
    which divided the target speed by the PID rate itself, and the gains and
    rate lived in a shared Constants struct.
    - Add Pid::Gains and make the PID take them, together with its computation
    rate, on construction.
    - Replace set_setpoint() by set_target_speed(), which takes ticks per second
    and converts to ticks per period inside the PID, with the same integer
    division as before. The division is done in signed 32 bits, since on AVR
    dividing a 16-bit speed by a 16-bit unsigned rate would be unsigned.
    - Expose the computation period as Pi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
2026-10-19 [andino_firmware] Inject the application configuration and remove Constants (#364)
    The Constants struct was a bag of unrelated settings that coupled the
    modules reading them and could not be changed per instance.
    - Add App::Config, with the auto-stop window, the PID rate and the initial PID
    gains, and pass it to the App on construction.
    - Create the configuration in main.cpp, which is the only place that knows the
    tuning of this robot.
    - Remove constants.h. The application and its tests no longer depend on
    global settings, so the tests can create applications with different
    configurations.
    - Add tests that check that the auto-stop window, the PID rate and the PID
    gains come from t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
2026-10-19 [andino_firmware] Move the hardware pin configuration to the BSP (#365)
    The pin assignment describes the board, but lived in the application layer
    even though nothing but main.cpp uses it. Move hw.h to the BSP, where the rest
    of the board-specific code is, and document that only the BSP and the
    composition root use it, so the application and the drivers keep depending
    only on the HAL interfaces.
2026-10-19 [andino_firmware] Add board packages and organize the BSP by platform (#366)
    What changes from one board to another was spread over the BSP, main.cpp and
    platformio.ini, and the BSP mixed code that only uses the Arduino API with
    code specific to AVR.
    - Add one board package per supported board, in boards/<board>/andino/board.h,
    with the pins, the serial baud rate and the application configuration. It
    replaces hw.h and the board specific data of main.cpp, which no longer has
    any. The Arduino Nano package just reuses the Arduino Uno one, as they have
    the same microcontroller and pin numbering.
    - Split the BSP implementations in bsp/arduino, which only use the Arduino API
    and work on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
2026-10-19 [andino_firmware] Make the shared Arduino code portable across platforms (#367)
    * [andino_firmware] Use the Arduino setup() and loop() entry points
    The firmware defined its own main(), which replaces the one of the Arduino
    core. The core's main() does more than call setup() and loop() on some
    platforms (it initializes the board variant), and it calls the serial event
    callbacks, which is an AVR specific symbol in our own code.
    Define setup() and loop() instead and let the core run them. On AVR the core
    does exactly what the custom main() did, so the firmware is unchanged.
    * [andino_firmware] Print integers with explicit fixed-wi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
2026-10-19 [andino_firmware] Add support for the STM32 Blue Pill (#368)
    * [andino_firmware] Add support for the STM32 Blue Pill
    Add the STM32 Blue Pill (STM32F103C8T6) as a board:
    - Add its board package, with the pins and the application configuration.
    The serial port is the USB CDC one, so the baud rate is unused.
    - Add the STM32 implementation of the interrupt inputs, with the Arduino
    attachInterrupt() function, in bsp/stm32.
    - Add the base configuration of the STM32 platform and the Blue Pill
    environment, which enables the USB serial port of the framework and
    flashes with an ST-Link. Pin the platform, the framework and the toolchain,
    and move what the Arduino boards share to its own bas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
2026-10-19 [andino_firmware] Fix the overflow when setting the lowest motor speed (#369)
    Motor::set_speed() negated negative speeds to get the PWM value, but negating
    the lowest value of an int overflows, which is undefined behavior. The lowest
    value of an int is INT16_MIN on AVR, and it can be sent to the motor with the
    set PWM command (the arguments are 16-bit integers), so the firmware of the
    boards could hit it.
    Saturate the speeds below the negative limit before negating them. Add tests
    for the lowest int and int16 values, and for the speeds around the limit. The
    first one is caught by the sanitizers of the unit tests without the fix.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
2026-10-19 [andino_firmware] Reply to too long commands with the error format (#370)
    A command line that doesn't fit in the shell buffer was answered with
    "Command too long.", the only failure reply without the "[ERROR]" prefix that
    the rest of them use, so the host couldn't tell it was an error. The shell
    also printed it itself, although the application owns the reply format.
    Make the shell report the discarded message through a callback, which is
    called when the message ends, and make the application reply with its error
    format: "[ERROR] Command too long".
    Add tests for the callback (reported once per message, silent without a
    callback, and not reported for the longest message that fits) and for th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
